Acous1/mmlab-12PhaseDrive-388Slave/SlaveDesignFiles/pinmap_sheet1/28388_0305.xlsx

功能分类 | 管脚序号 | 管脚功能 | 网标 | 复用IO说明 |  | 备注
CAN |  | CANA_TX | DSP_A_CAN_TX | 4 |  | CAN
 |  | CANA_RX | DSP_A_CAN_RX | 5
 |  | CANB_TX | DSP_B_CAN_TX | 8
 |  | CANB_RX | DSP_B_CAN_RX | 10
 |  | GPIO2 | DSP_A_CAN_EN | 2
 |  | GPIO9 | DSP_B_CAN_EN | 9
EQEP |  | EQEP1_A | MQEP1A | 50 |  | EQEP
 |  | EQEP1_B | MQEP1B | 51
 |  | EQEP1_INDEX | MQEP1Z | 53
SPI |  | SPIB_SOMI | MCU_EnDO_B1 | 25 | SPI数据从输出主输入 | 绝对编码器
 |  | SPIB_SIMO | MCU_EnDI_B1 | 24 | SPI数据主输出从输入
 |  | CLB_OUTPUTXBAR2 | MCU_CLK_B1 | 33 | CLK
 |  | GPIO7 | MCU_PwrEn_B1 | 7 | PwrEn
 |  | SPIB_SOMI | MCU_EnDO_B2 | 64 | SPI数据从输出主输入
 |  | SPIB_SIMO | MCU_EnDI_B2 | 63 | SPI数据主输出从输入
 |  | CLB_OUTPUTXBAR5 | MCU_CLK_B2 | 36 | CLK
 |  | GPIO95 | MCU_PwrEn_B2 | 95 | PwrEn
 |  | CLB_OUTPUTXBAR6 | MCU_TxEn_B | 96 | TxEn
 |  | SPID_SOMI | MCU_EnDO_D1 | 31 | SPI数据从输出主输入
 |  | SPID_SIMO | MCU_EnDI_D1 | 30 | SPI数据主输出从输入
 |  | CLB_OUTPUTXBAR1 | MCU_CLK_D1 | 32 | CLK
 |  | GPIO52 | MCU_PwrEn_D1 | 52 | PwrEn
 |  | SPID_SOMI | MCU_EnDO_D2 | 92 | SPI数据从输出主输入
 |  | SPID_SIMO | MCU_EnDI_D2 | 91 | SPI数据主输出从输入
 |  | CLB_OUTPUTXBAR8 | MCU_CLK_D2 | 98 | CLK
 |  | GPIO83 | MCU_PwrEn_D2 | 83 | PwrEn
 |  | CLB_OUTPUTXBAR7 | MCU_TxEn_D | 97 | TxEn
GPIO |  | GPIO43 | HALL_W | 43 |  | 增量式编码器 x_bar
 |  | GPIO42 | HALL_V | 42
 |  | GPIO133 | HALL_U | 133
 |  | GPIO113 | LED1 | 113 |  | LED
 |  | GPIO114 | LED2 | 114
 |  | GPIO118 | LED3 | 118
 |  | GPIO125 | LED4 | 125
 |  | GPIO120 | DI-1-DSP-3.3V | 120 |  | 数字输入
 |  | GPIO121 | DI-2-DSP-3.3V | 121
 |  | GPIO85 | DSP_PWM1~{_ENABL}E | 85 |  | PWM使能
 |  | GPIO88 | DSP_PWM2~{_ENABL}E | 88
 |  | GPIO89 | DSP_PWM3~{_ENABL}E | 89
 |  | GPIO90 | DSP_PWM4~{_ENABL}E | 90
 |  | GPIO93 | DSP_PWM1_~{FAULT} | 93 |  | 警告信号
 |  | GPIO94 | DSP_PWM2_~{FAULT} | 94
 |  | GPIO109 | DSP_PWM3_~{FAULT} | 109
 |  | GPIO117 | DSP_PWM4_~{FAULT} | 117
I2C |  | I2CB_SCL | MSCLB | 69 |  | 位移传感器
 |  | I2CB_SDA | MSDAB | 66
 |  | I2CA_SCL | MSCLA | 1
 |  | I2CA_SDA | MSDAA | 0
ADC | U2 | ADCINA2 | IPM_VDC_BUS1 |  |  | 电压AD
 | T2 | ADCINA3 | IPM_VDC_BUS2
 | V3 | ADCINB2 | IPM_VDC_BUS3
 | W3 | ADCINB3 | IPM_VDC_BUS4
 | V4 | ADCINB4 | IPM_Temperatur1 |  |  | 温度AD
 | W4 | ADCINB5 | IPM_Temperature2
 | R3 | ADCINC2 | IPM_Temperature3
 | P3 | ADCINC3 | IPM_Temperature4
PWM |  | EPWM1A | DSP-PWM1A | 145 |  | PWM波
 |  | EPWM1B | DSP-PWM1B | 146
 |  | EPWM2A | DSP-PWM2A | 147
 |  | EPWM2B | DSP-PWM2B | 3
 |  | EPWM3A | DSP-PWM3A | 149
 |  | EPWM3B | DSP-PWM3B | 150
 |  | EPWM4A | DSP-PWM4A | 151
 |  | EPWM4B | DSP-PWM4B | 152
 |  | EPWM5A | DSP-PWM5A | 153
 |  | EPWM5B | DSP-PWM5B | 154
 |  | EPWM6A | DSP-PWM6A | 155
 |  | EPWM6B | DSP-PWM6B | 11
 |  | EPWM7A | DSP-PWM7A | 12
 |  | EPWM7B | DSP-PWM7B | 13
 |  | EPWM8A | DSP-PWM8A | 14
 |  | EPWM8B | DSP-PWM8B | 15
 |  | EPWM9A | DSP-PWM9A | 16
 |  | EPWM9B | DSP-PWM9B | 17
 |  | EPWM10A | DSP-PWM10A | 18
 |  | EPWM10B | DSP-PWM10B | 19
 |  | EPWM11A | DSP-PWM11A | 20
 |  | EPWM11B | DSP-PWM11B | 21
 |  | EPWM12A | DSP-PWM12A | 22
 |  | EPWM12B | DSP-PWM12B | 23
 |  | EPWM15A | DSP_Discharge1_EN | 28 |  | 刹车发波
 |  | EPWM15B | DSP_Discharge2_EN | 29
 |  | EPWM16A | DSP_Discharge3_EN | 143
 |  | EPWM16B | DSP_Discharge4_EN | 144
ETHERCAT | B13 | ESC_I2C_SDA | ESC_I2C_SDA | 40 |  | ETHERCAT网口*2
 | C13 | ESC_I2C_SCL | ESC_I2C_SCL | 41
 | D13 | ESC_MDIO_CLK | ESC_MDC | 46
 | A12 | ESC_MDIO_DATA | ESC_MDIO | 47
 | B12 | ESC_PHY_CLK | ESC_PHY_CLK | 48
 | C12 | ESC_PHY_RESETn | ESC_RESET | 76
 | D12 | ESC_TX0_ENA | ESC_TX0_EN | 156
 | B10 | ESC_TX0_CLK | ESC_TX0_CLK | 157
 | C10 | ESC_TX0_DATA0 | ESC_TX0_D0 | 158
 | D10 | ESC_TX0_DATA1 | ESC_TX0_D1 | 159
 | B9 | ESC_TX0_DATA2 | ESC_TX0_D2 | 160
 | C9 | ESC_TX0_DATA3 | ESC_TX0_D3 | 161
 | D9 | ESC_RX0_DV | ESC_RX0_DV | 162
 | A8 | ESC_RX0_CLK | ESC_RX0_CLK | 163
 | B8 | ESC_RX0_ERR | ESC_RX0_ERR | 164
 | C5 | ESC_RX0_DATA0 | ESC_RX0_D0 | 165
 | D5 | ESC_RX0_DATA1 | ESC_RX0_D1 | 166
 | C4 | ESC_RX0_DATA2 | ESC_RX0_D2 | 167
 | D4 | ESC_RX0_DATA3 | ESC_RX0_D3 | 168
 | T10 | ESC_TX1_ENA | ESC_TX1_EN | 129
 | U10 | ESC_TX1_CLK | ESC_TX1_CLK | 130
 | V10 | ESC_TX1_DATA0 | ESC_TX1_D0 | 131
 | W18 | ESC_TX1_DATA1 | ESC_TX1_D1 | 132
 | V18 | ESC_TX1_DATA2 | ESC_TX1_D2 | 134
 | U18 | ESC_TX1_DATA3 | ESC_TX1_D3 | 135
 | T17 | ESC_RX1_DV | ESC_RX1_DV | 136
 | T18 | ESC_RX1_CLK | ESC_RX1_CLK | 137
 | T19 | ESC_RX1_ERR | ESC_RX1_ERR | 71
 | N19 | ESC_RX1_DATA0 | ESC_RX1_D0 | 139
 | M19 | ESC_RX1_DATA1 | ESC_RX1_D1 | 140
 | K16 | ESC_RX1_DATA2 | ESC_RX1_D2 | 141
 | L19 | ESC_RX1_DATA3 | ESC_RX1_D3 | 142
 | F18 | ESC_LED_LINK0_ACTIVE | ESC_LED_LINK0 | 58
 | F17 | ESC_LED_LINK1_ACTIVE | ESC_LED_LINK1 | 59
 | E17 | ESC_LED_ERR | ESC_LED_ERR | 60
 | D18 | ESC_LED_RUN | ESC_LED_RUN | 61
 | D14 | ESC_PHY0_LINKSTATUS | ESC_PHY0 | 148
 | A13 | ESC_PHY1_LINKSTATUS | ESC_PHY1 | 68
 | A16 | XCLKOUT | XCLKOUT | 73
SDFM |  | SD1_C1 | ADC_CLK_1 | 49 | SDFM1模拟时钟输入 | AD电流检测
 |  | SD2_C1 | ADC_CLK_3 | 80 | SDFM3模拟时钟输入
 |  | SD1_D1 | ADC_DO_V_1 | 122 | 1-V相电流
 |  | SD1_D2 | ADC_DO_W_1 | 124 | 1-W相电流
 |  | SD1_D3 | ADC_DO_V_2 | 126 | 2-V相电流
 |  | SD1_D4 | ADC_DO_W_2 | 128 | 2-W相电流
 |  | SD2_D1 | ADC_DO_V_3 | 79 | 3-V相电流
 |  | SD2_D2 | ADC_DO_W_3 | 26 | 3-W相电流
 |  | SD2_D3 | ADC_DO_V_4 | 75 | 4-V相电流
 |  | SD2_D4 | ADC_DO_W_4 | 77 | 4-W相电流
FSI |  | FSIRXA_CLK | FSI_RXA_CLK | 105 |  | FSI*2
 |  | FSIRXA_D0 | FSI_RXA_D0 | 103
 |  | FSIRXA_D1 | FSI_RXA_D1 | 104
 |  | FSIRXB_CLK | FSI_RXB_CLK | 112
 |  | FSIRXB_D0 | FSI_RXB_D0 | 110
 |  | FSIRXB_D1 | FSI_RXB_D1 | 111
 |  | FSITXA_CLK | FSI_TXA_CLK | 102
 |  | FSITXA_D0 | FSI_TXA_D0 | 100
 |  | FSITXA_D1 | FSI_TXA_D1 | 101
 |  | FSITXB_CLK | FSI_TXB_CLK | 108
 |  | FSITXB_D0 | FSI_TXB_D0 | 106
 |  | FSITXB_D1 | FSI_TXB_D1 | 107
485上位机 |  | SCIA_TX | USB485_TXD | 34 |  | 485通讯转USB
 |  | SCIA_RX | USB485_RXD | 35
SPI |  | SPIA_SIMO | SPI_A_MO_HS | 54 |  | DAC
 |  | SPIA_SOMI | SPI_A_MI_HS | 55
 |  | SPIA_CLK | SPI_A_CK_HS | 56
 |  | SPIA_STEn | ~{SPI_A_STE_HS} | 57
高速485 |  | SCIB_TX | MCU_485D_1 | 86 |  | 485
 |  | SCIB_RX | MCU_485R_1 | 87
 |  | GPIO138 | 485_RTS_1 | 138
 |  | SCIC_TX | MCU_485D_2 | 38
 |  | SCIC_RX | MCU_485R_2 | 39
 |  | GPIO45 | 485_RTS_2 | 45
 |  |  |  | 72 |  | BOOT
 |  |  |  | 84
