Acous1/mmlab-12PhaseDrive-388Slave/SlaveDesignFiles/嘉立创叠层选择.png

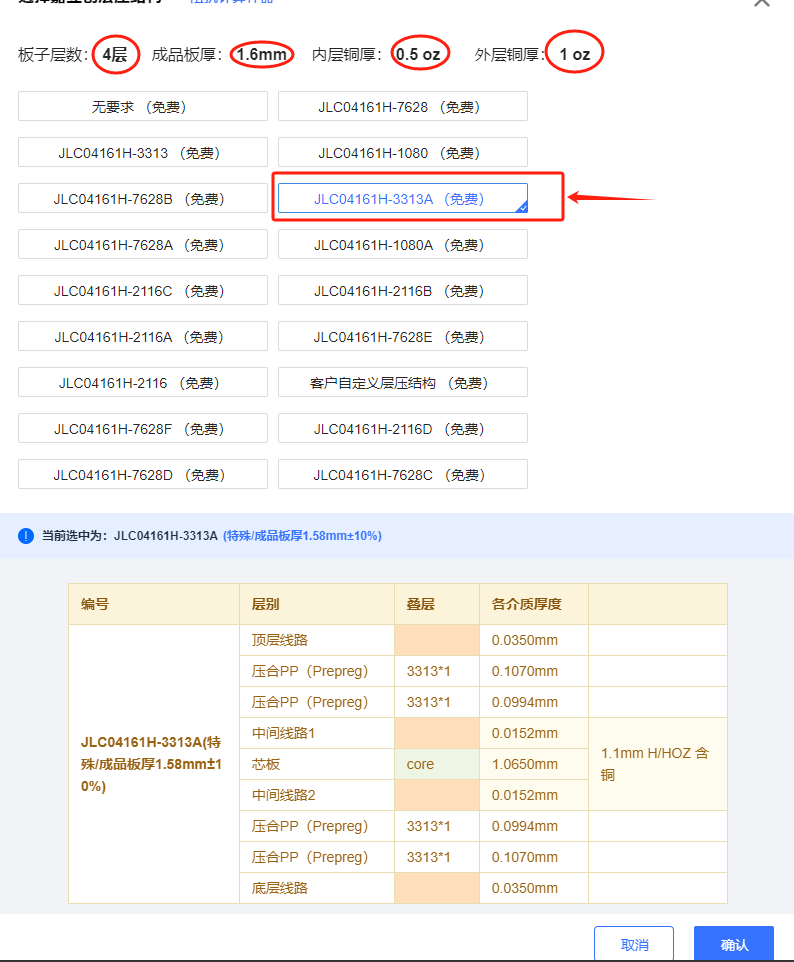
SlaveDesignFiles/嘉立创叠层选择.png
