Acous1/mmlab-12PhaseDrive-388Slave/SlaveDesignFiles/阻抗叠层下的线宽线距计算.png

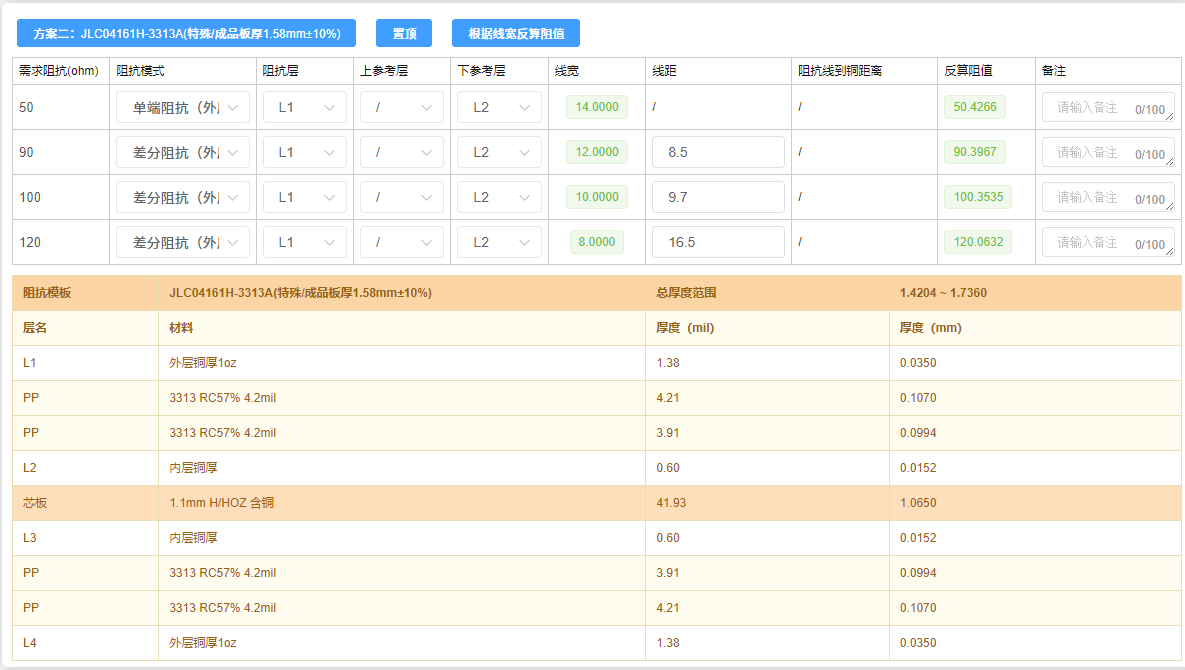
SlaveDesignFiles/阻抗叠层下的线宽线距计算.png
