Acous1/mmlab-12PhaseDrive-388Slave/SlaveDesignFiles/2.kicad_sch

## KiCad design SlaveDesignFiles/2.kicad_sch (2025-04-16)

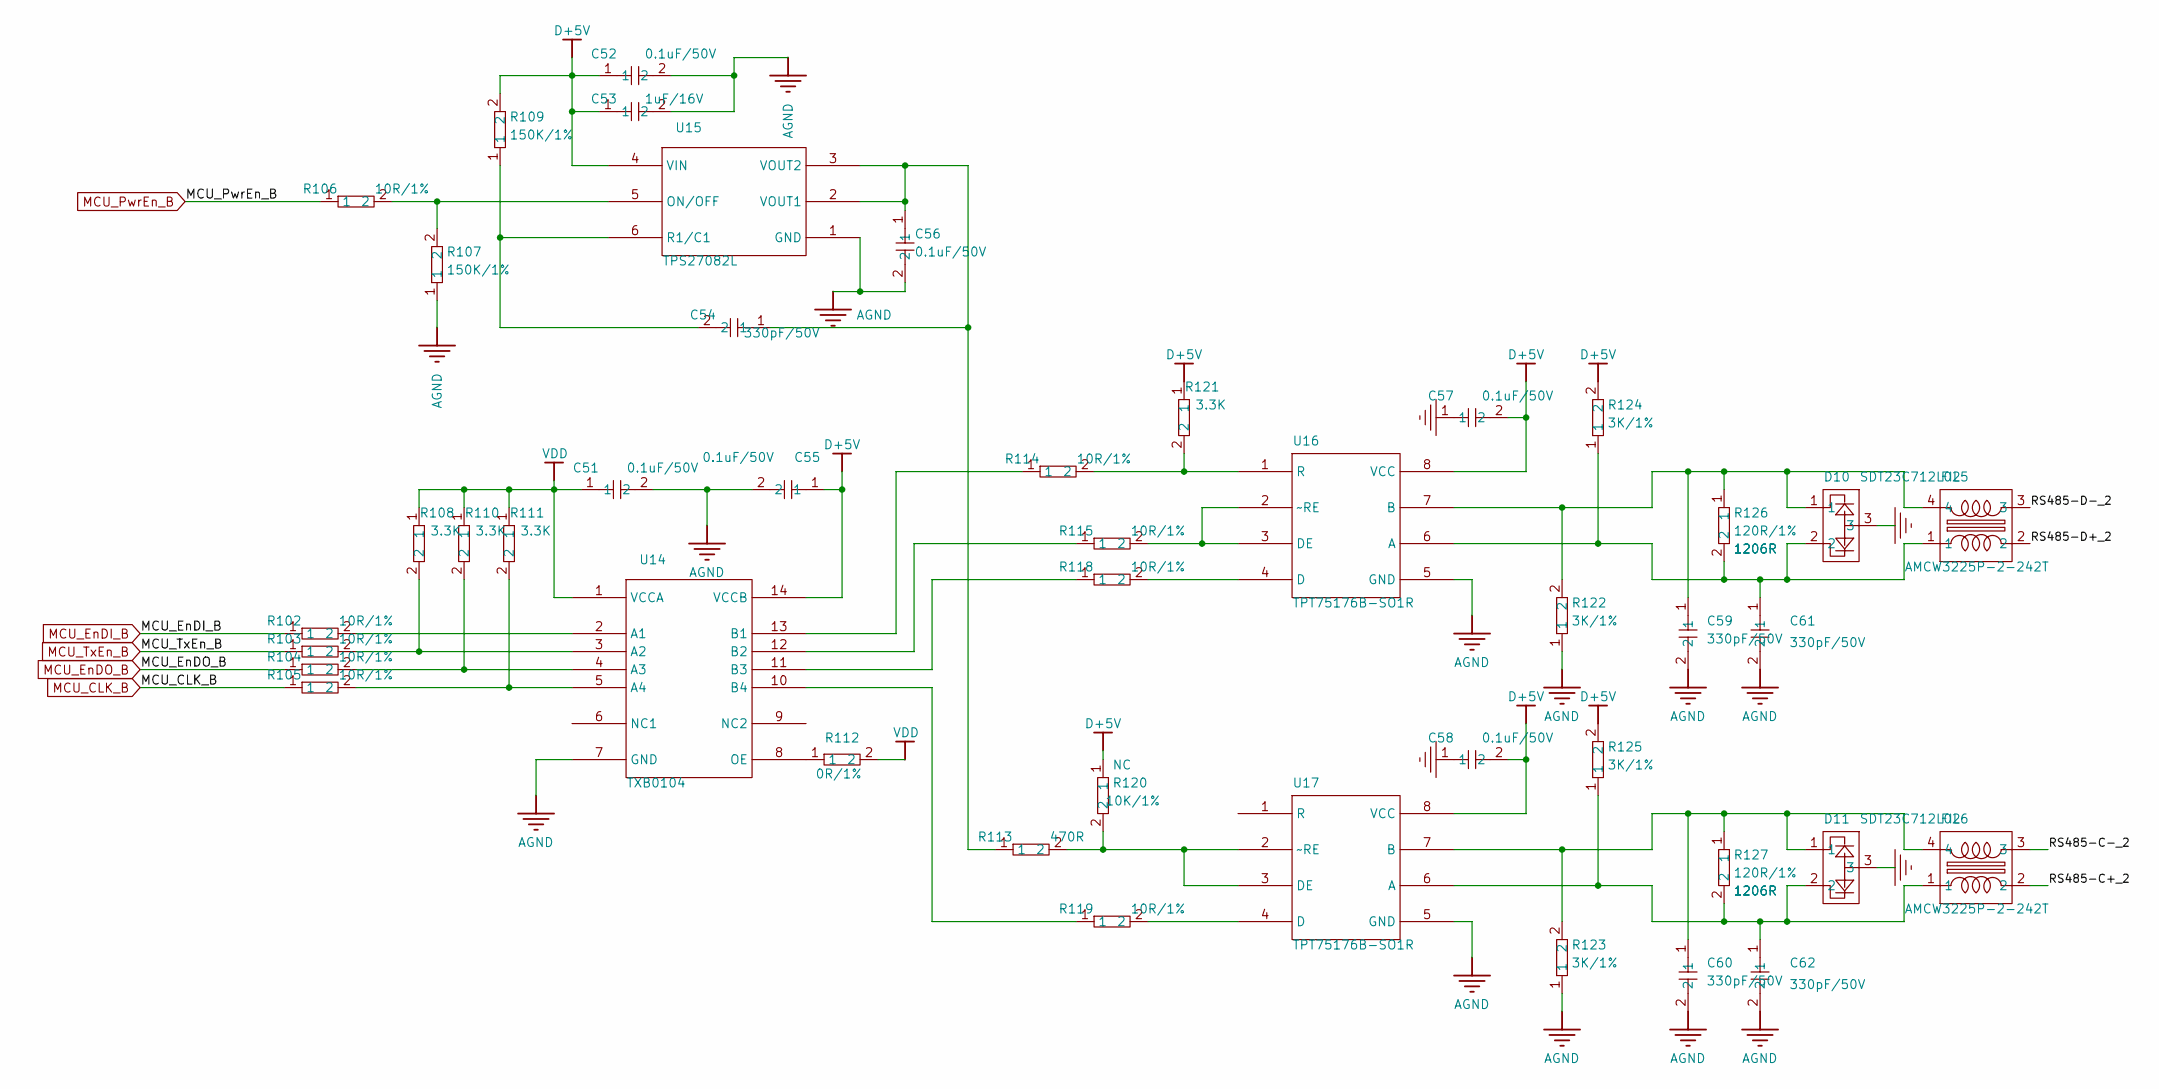
[picture p5: schematic 2.kicad_sch]

Parts:
C51, C52, C55, C56, C57, C58: 0.1uF/50V; Part State 已认定
C53: 1uF/16V; Part State 已认定
C54, C59, C60, C61, C62: 330pF/50V; Part State 已认定
D10, D11: SDT23C712L02
FIL5, FIL6: AMCW3225P-2-242T
R102, R103, R104, R105, R106, R114, R115, R118, R119: 10R/1%; Part State 已认定
R107, R109: 150K/1%; Part State 已认定
R108, R110, R111, R121: 3.3K; Part State 已认定
R112: 0R/1%; Part State 已认定
R113: 470R; Part State 已认定
R120: 10K/1%; Part State 已认定
R122, R123, R124, R125: 3K/1%; Part State 未认定
R126, R127: 120R/1%; Part State 已认定
U14: TXB0104
U15: TPS27082L
U16, U17: TPT75176B-SO1R

Connections:
AGND: C51.2, C52.2, C53.2, C55.2, C56.2, C59.2, C60.2, C61.2, C62.2, R107.1, R122.1, R123.1, U14.7 (GND), U15.1 (GND), U16.5 (GND), U17.5 (GND)
D+5V: C52.1, C53.1, C55.1, C57.2, C58.2, R109.2, R120.1, R121.1, R124.2, R125.2, U14.14 (VCCB), U15.4 (VIN), U16.8 (VCC), U17.8 (VCC)
GND: C57.1, C58.1, D10.3, D11.3
MCU_CLK_B: R105.1
MCU_EnDI_B: R102.1
MCU_EnDO_B: R104.1
MCU_PwrEn_B: R106.1
MCU_TxEn_B: R103.1
unnamed: C54.1, C56.1, R113.1, U15.2 (VOUT1), U15.3 (VOUT2)
unnamed: C54.2, R109.1, U15.6 (R1/C1)
unnamed: C59.1, D10.1, FIL5.4, R122.2, R126.1, U16.7 (B)
unnamed: C60.1, D11.1, FIL6.4, R123.2, R127.1, U17.7 (B)
unnamed: C61.1, D10.2, FIL5.1, R124.1, R126.2, U16.6 (A)
unnamed: C62.1, D11.2, FIL6.1, R125.1, R127.2, U17.6 (A)
unnamed: R102.2, U14.2 (A1)
unnamed: R103.2, R108.2, U14.3 (A2)
unnamed: R104.2, R110.2, U14.4 (A3)
unnamed: R105.2, R111.2, U14.5 (A4)
unnamed: R106.2, R107.2, U15.5 (ON/OFF)
unnamed: R112.1, U14.8 (OE)
unnamed: R113.2, R120.2, U17.2 (~RE), U17.3 (DE)
unnamed: R114.1, U14.13 (B1)
unnamed: R114.2, R121.2, U16.1 (R)
unnamed: R115.1, U14.12 (B2)
unnamed: R115.2, U16.2 (~RE), U16.3 (DE)
unnamed: R118.1, U14.11 (B3)
unnamed: R118.2, U16.4 (D)
unnamed: R119.1, U14.10 (B4)
unnamed: R119.2, U17.4 (D)
RS485-C+_2: FIL6.2
RS485-C-_2: FIL6.3
RS485-D+_2: FIL5.2
RS485-D-_2: FIL5.3
VDD: C51.1, R108.1, R110.1, R111.1, R112.2, U14.1 (VCCA)
