Acous1/mmlab-12PhaseDrive-388Slave/SlaveDesignFiles/3.kicad_sch

## KiCad design SlaveDesignFiles/3.kicad_sch (2025-04-16)

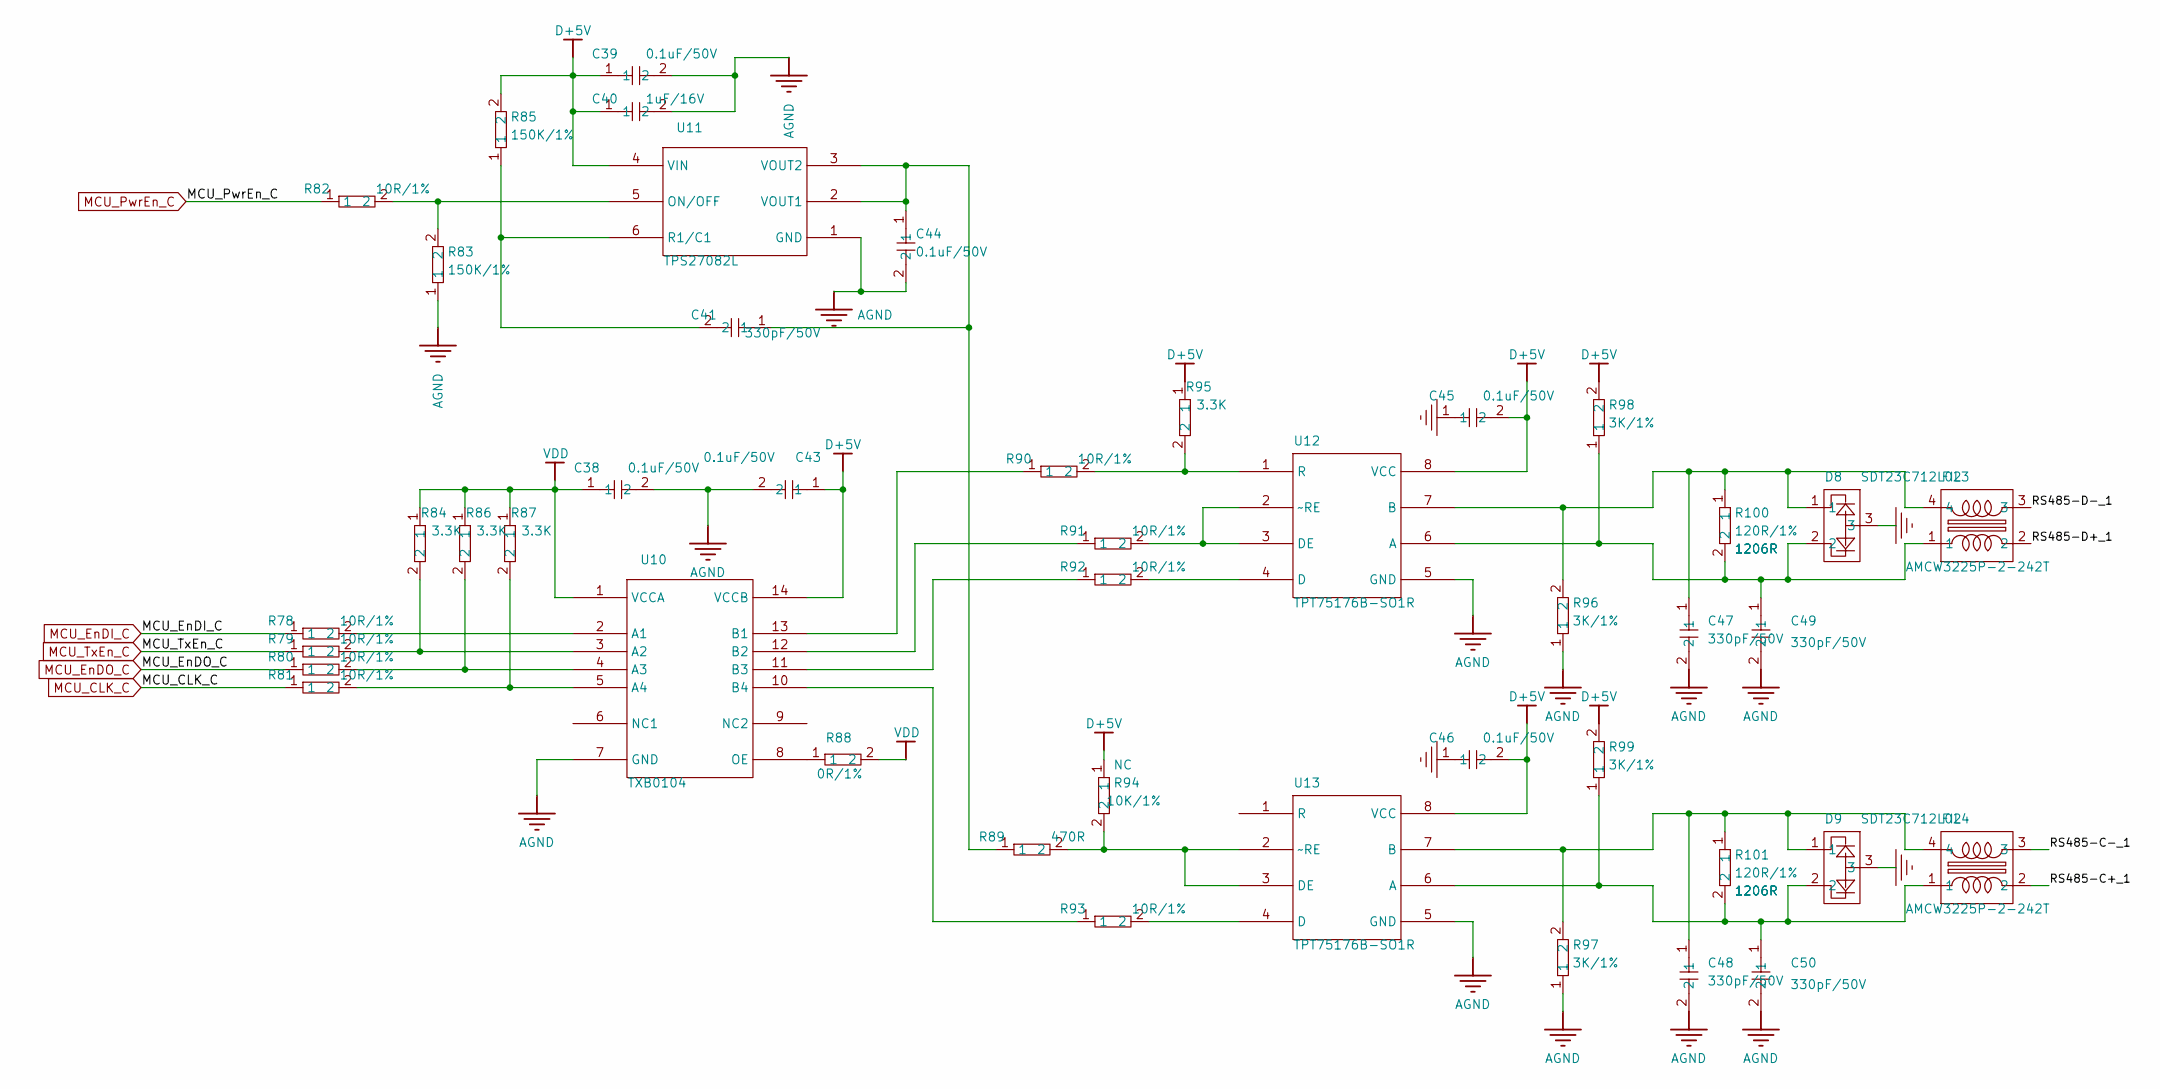
[picture p6: schematic 3.kicad_sch]

Parts:
C38, C39, C43, C44, C45, C46: 0.1uF/50V; Part State 已认定
C40: 1uF/16V; Part State 已认定
C41, C47, C48, C49, C50: 330pF/50V; Part State 已认定
D8, D9: SDT23C712L02
FIL3, FIL4: AMCW3225P-2-242T
R78, R79, R80, R81, R82, R90, R91, R92, R93: 10R/1%; Part State 已认定
R83, R85: 150K/1%; Part State 已认定
R84, R86, R87, R95: 3.3K; Part State 已认定
R88: 0R/1%; Part State 已认定
R89: 470R; Part State 已认定
R94: 10K/1%; Part State 已认定
R96, R97, R98, R99: 3K/1%; Part State 未认定
R100, R101: 120R/1%; Part State 已认定
U10: TXB0104
U11: TPS27082L
U12, U13: TPT75176B-SO1R

Connections:
AGND: C38.2, C39.2, C40.2, C43.2, C44.2, C47.2, C48.2, C49.2, C50.2, R83.1, R96.1, R97.1, U10.7 (GND), U11.1 (GND), U12.5 (GND), U13.5 (GND)
D+5V: C39.1, C40.1, C43.1, C45.2, C46.2, R85.2, R94.1, R95.1, R98.2, R99.2, U10.14 (VCCB), U11.4 (VIN), U12.8 (VCC), U13.8 (VCC)
GND: C45.1, C46.1, D8.3, D9.3
MCU_CLK_C: R81.1
MCU_EnDI_C: R78.1
MCU_EnDO_C: R80.1
MCU_PwrEn_C: R82.1
MCU_TxEn_C: R79.1
unnamed: C41.1, C44.1, R89.1, U11.2 (VOUT1), U11.3 (VOUT2)
unnamed: C41.2, R85.1, U11.6 (R1/C1)
unnamed: C47.1, D8.1, FIL3.4, R96.2, R100.1, U12.7 (B)
unnamed: C48.1, D9.1, FIL4.4, R97.2, R101.1, U13.7 (B)
unnamed: C49.1, D8.2, FIL3.1, R98.1, R100.2, U12.6 (A)
unnamed: C50.1, D9.2, FIL4.1, R99.1, R101.2, U13.6 (A)
unnamed: R78.2, U10.2 (A1)
unnamed: R79.2, R84.2, U10.3 (A2)
unnamed: R80.2, R86.2, U10.4 (A3)
unnamed: R81.2, R87.2, U10.5 (A4)
unnamed: R82.2, R83.2, U11.5 (ON/OFF)
unnamed: R88.1, U10.8 (OE)
unnamed: R89.2, R94.2, U13.2 (~RE), U13.3 (DE)
unnamed: R90.1, U10.13 (B1)
unnamed: R90.2, R95.2, U12.1 (R)
unnamed: R91.1, U10.12 (B2)
unnamed: R91.2, U12.2 (~RE), U12.3 (DE)
unnamed: R92.1, U10.11 (B3)
unnamed: R92.2, U12.4 (D)
unnamed: R93.1, U10.10 (B4)
unnamed: R93.2, U13.4 (D)
RS485-C+_1: FIL4.2
RS485-C-_1: FIL4.3
RS485-D+_1: FIL3.2
RS485-D-_1: FIL3.3
VDD: C38.1, R84.1, R86.1, R87.1, R88.2, U10.1 (VCCA)
