Acous1/mmlab-12PhaseDrive-388Slave/SlaveDesignFiles/4.kicad_sch

## KiCad design SlaveDesignFiles/4.kicad_sch (2025-04-16)

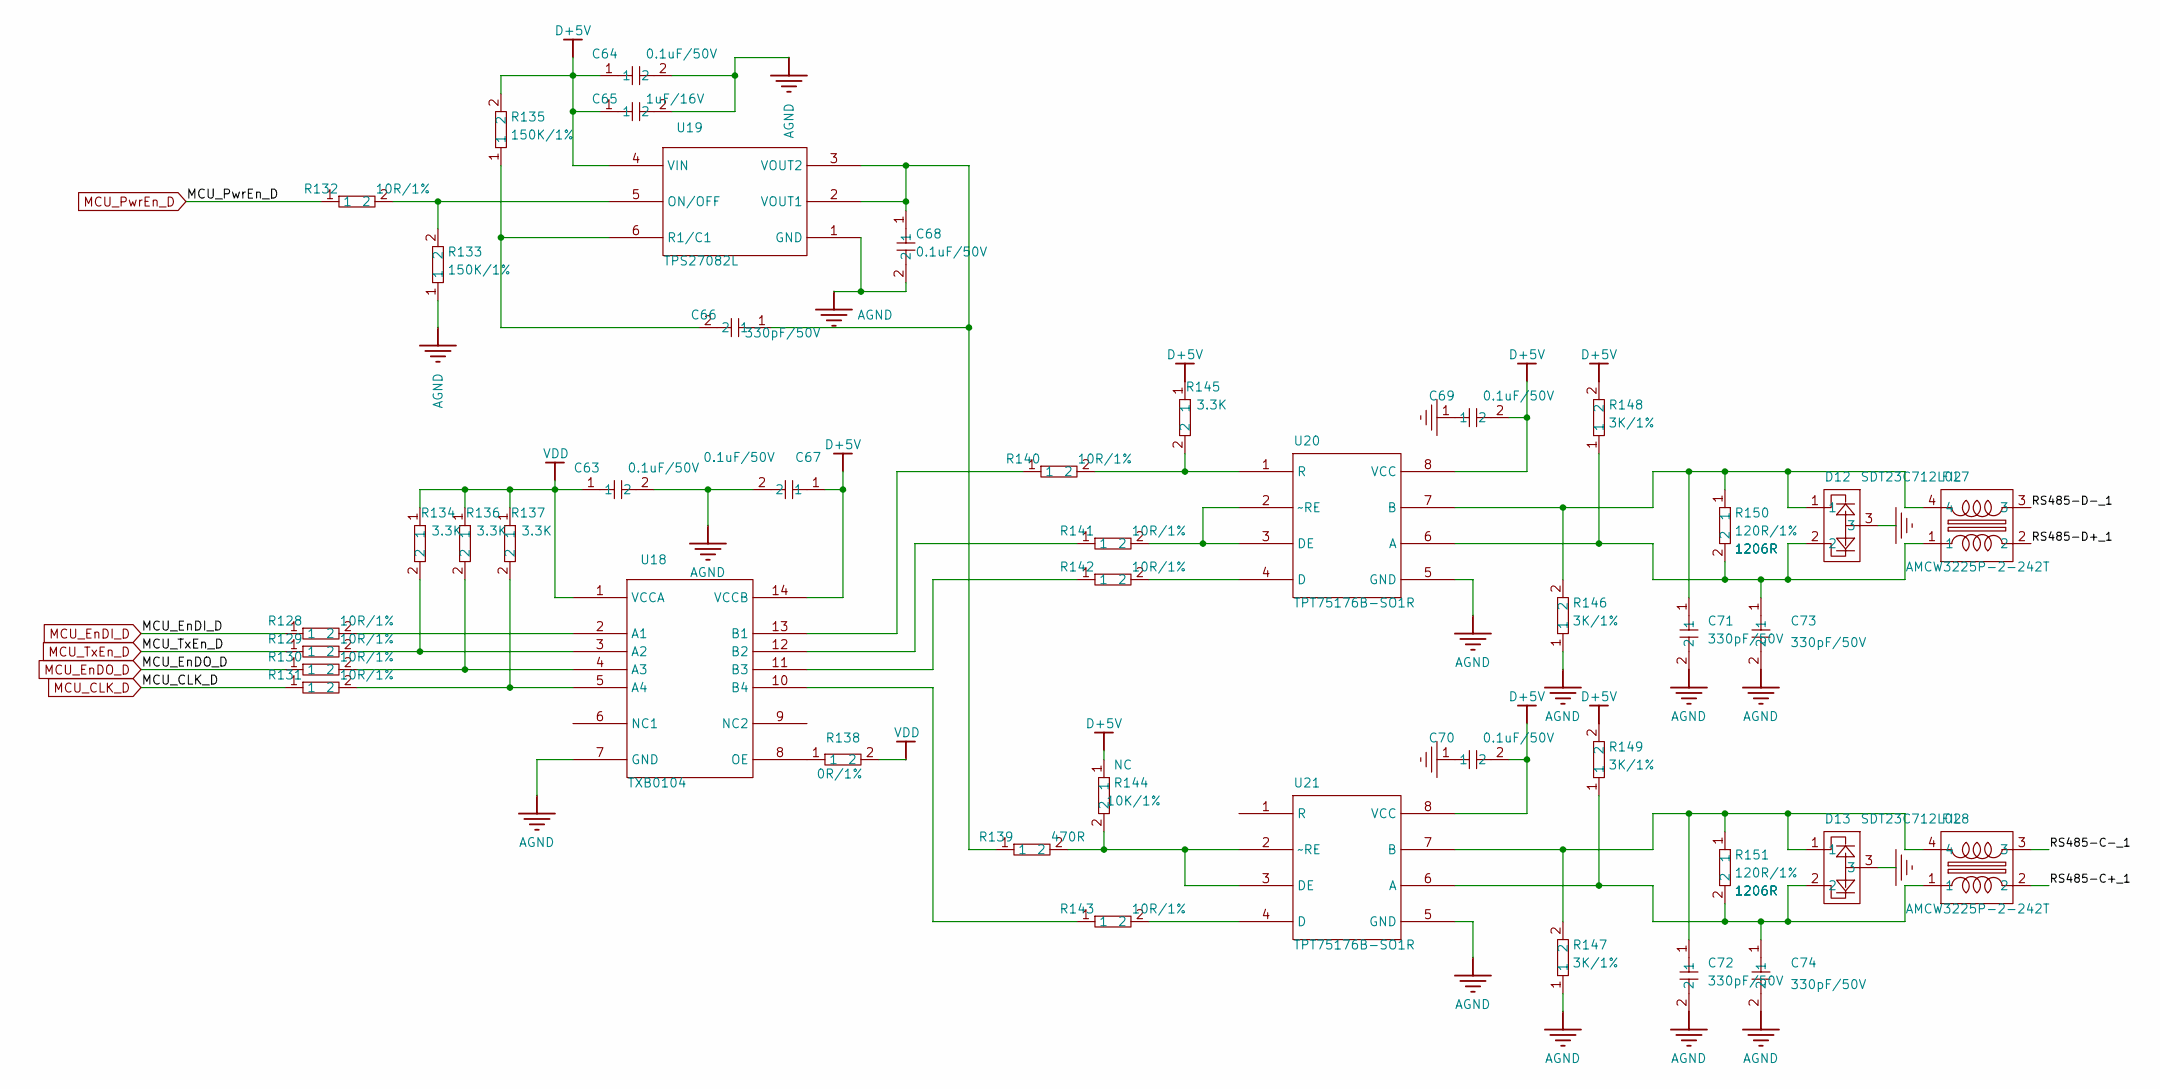
[picture p7: schematic 4.kicad_sch]

Parts:
C63, C64, C67, C68, C69, C70: 0.1uF/50V; Part State 已认定
C65: 1uF/16V; Part State 已认定
C66, C71, C72, C73, C74: 330pF/50V; Part State 已认定
D12, D13: SDT23C712L02
FIL7, FIL8: AMCW3225P-2-242T
R128, R129, R130, R131, R132, R140, R141, R142, R143: 10R/1%; Part State 已认定
R133, R135: 150K/1%; Part State 已认定
R134, R136, R137, R145: 3.3K; Part State 已认定
R138: 0R/1%; Part State 已认定
R139: 470R; Part State 已认定
R144: 10K/1%; Part State 已认定
R146, R147, R148, R149: 3K/1%; Part State 未认定
R150, R151: 120R/1%; Part State 已认定
U18: TXB0104
U19: TPS27082L
U20, U21: TPT75176B-SO1R

Connections:
AGND: C63.2, C64.2, C65.2, C67.2, C68.2, C71.2, C72.2, C73.2, C74.2, R133.1, R146.1, R147.1, U18.7 (GND), U19.1 (GND), U20.5 (GND), U21.5 (GND)
D+5V: C64.1, C65.1, C67.1, C69.2, C70.2, R135.2, R144.1, R145.1, R148.2, R149.2, U18.14 (VCCB), U19.4 (VIN), U20.8 (VCC), U21.8 (VCC)
GND: C69.1, C70.1, D12.3, D13.3
MCU_CLK_D: R131.1
MCU_EnDI_D: R128.1
MCU_EnDO_D: R130.1
MCU_PwrEn_D: R132.1
MCU_TxEn_D: R129.1
unnamed: C66.1, C68.1, R139.1, U19.2 (VOUT1), U19.3 (VOUT2)
unnamed: C66.2, R135.1, U19.6 (R1/C1)
unnamed: C71.1, D12.1, FIL7.4, R146.2, R150.1, U20.7 (B)
unnamed: C72.1, D13.1, FIL8.4, R147.2, R151.1, U21.7 (B)
unnamed: C73.1, D12.2, FIL7.1, R148.1, R150.2, U20.6 (A)
unnamed: C74.1, D13.2, FIL8.1, R149.1, R151.2, U21.6 (A)
unnamed: R128.2, U18.2 (A1)
unnamed: R129.2, R134.2, U18.3 (A2)
unnamed: R130.2, R136.2, U18.4 (A3)
unnamed: R131.2, R137.2, U18.5 (A4)
unnamed: R132.2, R133.2, U19.5 (ON/OFF)
unnamed: R138.1, U18.8 (OE)
unnamed: R139.2, R144.2, U21.2 (~RE), U21.3 (DE)
unnamed: R140.1, U18.13 (B1)
unnamed: R140.2, R145.2, U20.1 (R)
unnamed: R141.1, U18.12 (B2)
unnamed: R141.2, U20.2 (~RE), U20.3 (DE)
unnamed: R142.1, U18.11 (B3)
unnamed: R142.2, U20.4 (D)
unnamed: R143.1, U18.10 (B4)
unnamed: R143.2, U21.4 (D)
RS485-C+_1: FIL8.2
RS485-C-_1: FIL8.3
RS485-D+_1: FIL7.2
RS485-D-_1: FIL7.3
VDD: C63.1, R134.1, R136.1, R137.1, R138.2, U18.1 (VCCA)
