Acous1/mmlab-12PhaseDrive-388Slave/SlaveDesignFiles/5.kicad_sch

## KiCad design SlaveDesignFiles/5.kicad_sch (2025-04-16)

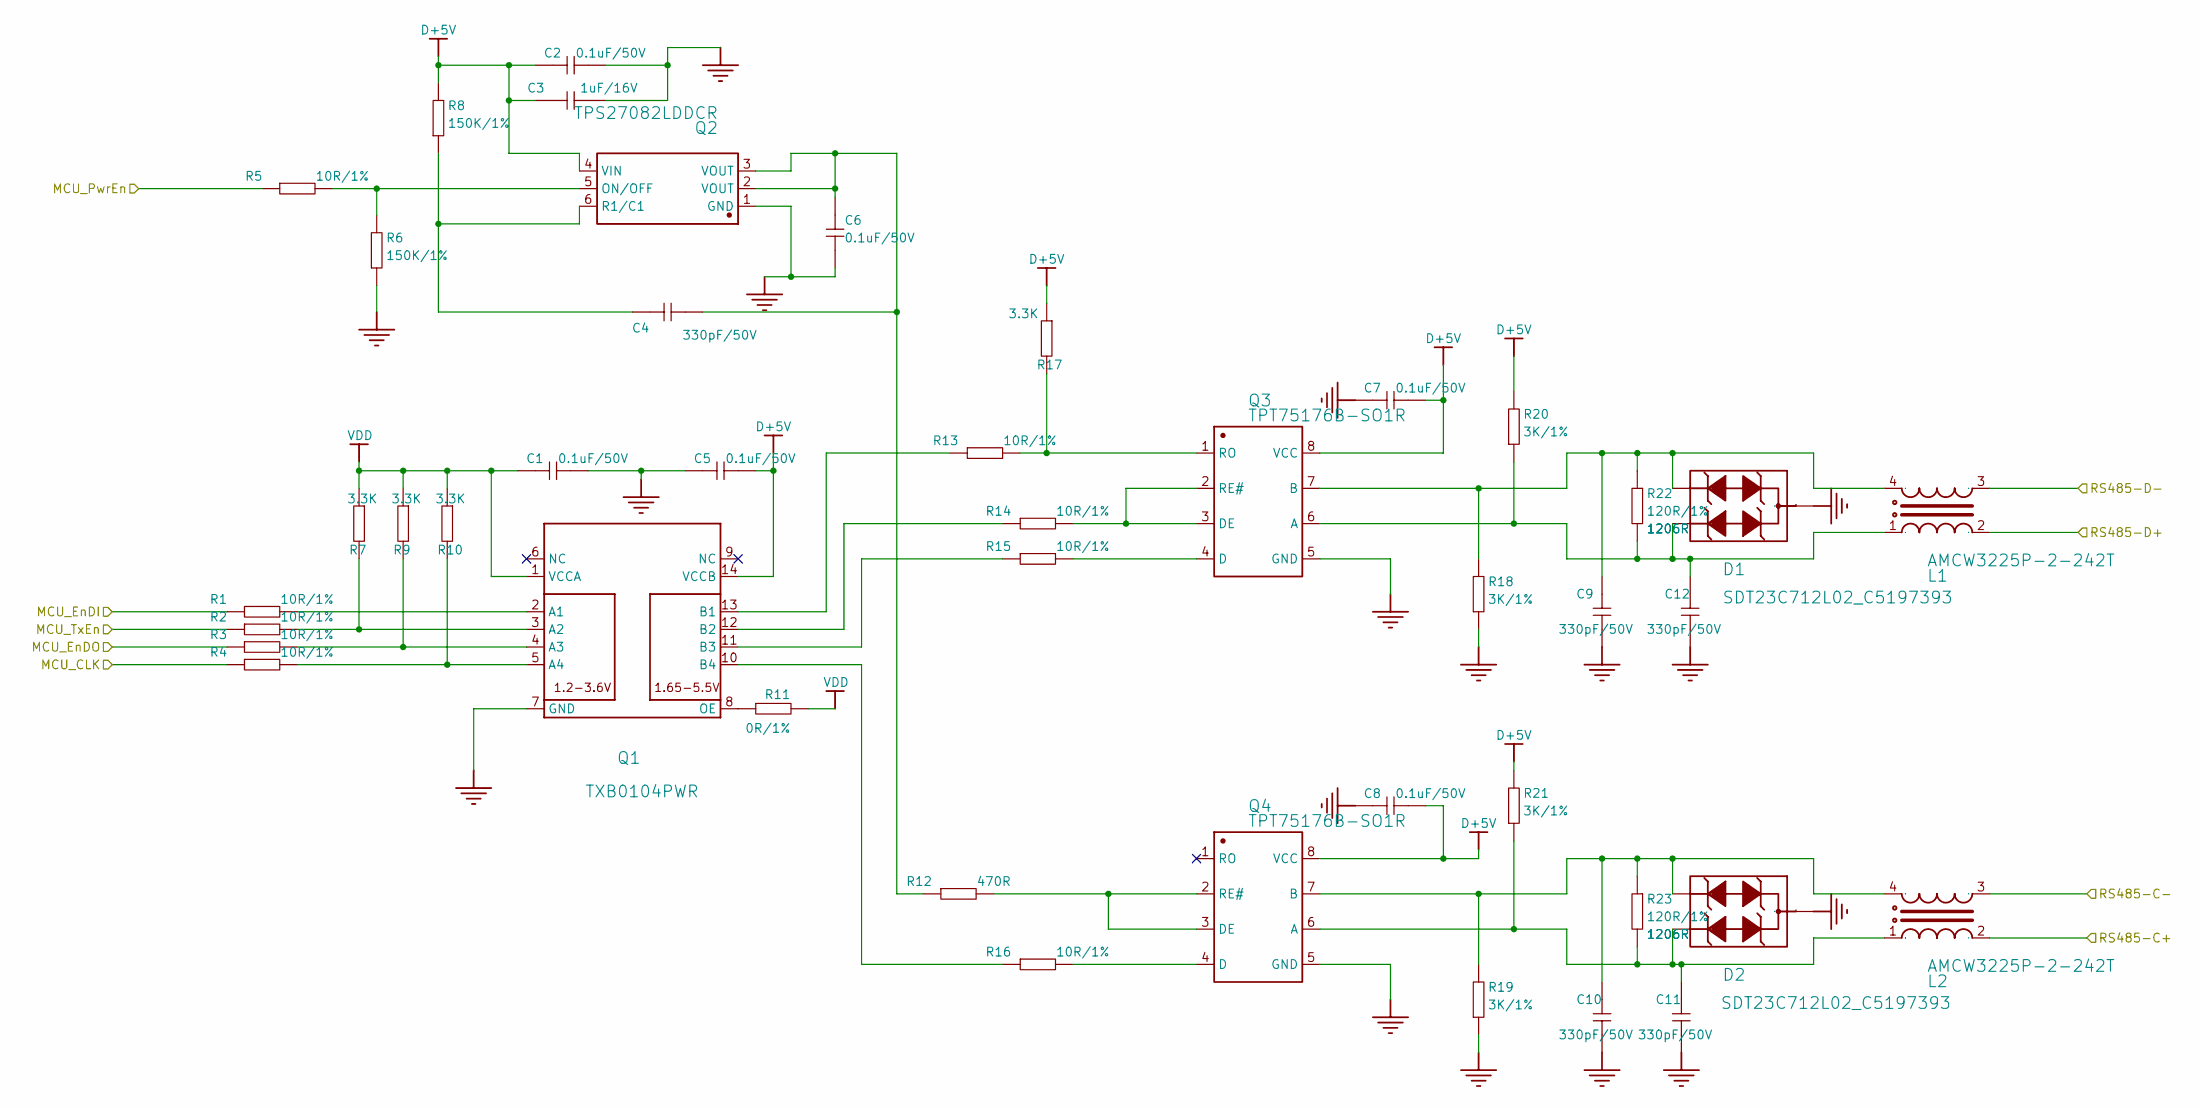
[picture p8: schematic 5.kicad_sch]

Parts:
C1, C2, C5, C6, C7, C8: 0.1uF/50V; C_0603_1608Metric; Part State 已认定
C3: 1uF/16V; C_0603_1608Metric; Part State 已认定
C4, C9, C10, C11, C12: 330pF/50V; C_0603_1608Metric; Part State 已认定
D1, D2: SDT23C712L02_C5197393; SOT-23-3_L2.9-W1.3-P1.90-LS2.4-BR; Manufacturer Part SDT23C712L02
L1, L2: AMCW3225P-2-242T; FILTER-SMD_4P-L3.2-W2.5-BL_WCM3225XXXX; Manufacturer Part AMCW3225P-2-242T
Q1: TXB0104PWR; TSSOP-14_L5.0-W4.4-P0.65-LS6.4-BL; Manufacturer Part TXB0104PWR
Q2: TPS27082LDDCR; SOT-23-6_L2.9-W1.6-P0.95-LS2.8-BR; Manufacturer Part TPS27082LDDCR
Q3, Q4: TPT75176B-SO1R; SOP-8_L4.9-W3.9-P1.27-LS6.0-BL; Manufacturer Part TPT75176B-SO1R
R1, R2, R3, R4, R5, R13, R14, R15, R16: 10R/1%; R_0603_1608Metric; Part State 已认定
R6, R8: 150K/1%; R_0603_1608Metric; Part State 已认定
R7, R9, R10, R17: 3.3K; R_0603_1608Metric; Part State 已认定
R11: 0R/1%; R_0603_1608Metric; Part State 已认定
R12: 470R; R_0603_1608Metric; Part State 已认定
R18, R19, R20, R21: 3K/1%; R_0603_1608Metric; Part State 未认定
R22, R23: 120R/1%; R_1206_3216Metric; Part State 已认定

Connections:
AGND: C1.2, C2.2, C3.2, C5.1, C6.2, C7.1, C8.1, C9.2, C10.2, C11.2, C12.2, D1.3, D2.3, Q1.7 (GND), Q2.1 (GND), Q3.5 (GND), Q4.5 (GND), R6.1, R18.1, R19.1
D+5V: C2.1, C3.1, C5.2, C7.2, C8.2, Q1.14 (VCCB), Q2.4 (VIN), Q3.8 (VCC), Q4.8 (VCC), R8.2, R17.1, R20.2, R21.2
MCU_CLK: R4.1
MCU_EnDI: R1.1
MCU_EnDO: R3.1
MCU_PwrEn: R5.1
MCU_TxEn: R2.1
unnamed: C4.1, Q2.6 (R1/C1), R8.1
unnamed: C4.2, C6.1, Q2.2 (VOUT), Q2.3 (VOUT), R12.1
unnamed: C9.1, D1.1, L1.4, Q3.7 (B), R18.2, R22.1
unnamed: C10.1, D2.1, L2.4, Q4.7 (B), R19.2, R23.1
unnamed: C11.1, D2.2, L2.1, Q4.6 (A), R21.1, R23.2
unnamed: C12.1, D1.2, L1.1, Q3.6 (A), R20.1, R22.2
unnamed: Q1.2 (A1), R1.2
unnamed: Q1.3 (A2), R2.2, R7.2
unnamed: Q1.4 (A3), R3.2, R9.2
unnamed: Q1.5 (A4), R4.2, R10.2
unnamed: Q1.8 (OE), R11.1
unnamed: Q1.10 (B4), R16.1
unnamed: Q1.11 (B3), R15.1
unnamed: Q1.12 (B2), R14.1
unnamed: Q1.13 (B1), R13.1
unnamed: Q2.5 (ON/OFF), R5.2, R6.2
unnamed: Q3.1 (RO), R13.2, R17.2
unnamed: Q3.2 (RE#), Q3.3 (DE), R14.2
unnamed: Q3.4 (D), R15.2
unnamed: Q4.2 (RE#), Q4.3 (DE), R12.2
unnamed: Q4.4 (D), R16.2
RS485-C+: L2.2
RS485-C-: L2.3
RS485-D+: L1.2
RS485-D-: L1.3
VDD: C1.1, Q1.1 (VCCA), R7.1, R9.1, R10.1, R11.2
