Acous1/mmlab-12PhaseDrive-388Slave/SlaveDesignFiles/26c32.kicad_sch

## KiCad design SlaveDesignFiles/26c32.kicad_sch (2025-04-16)

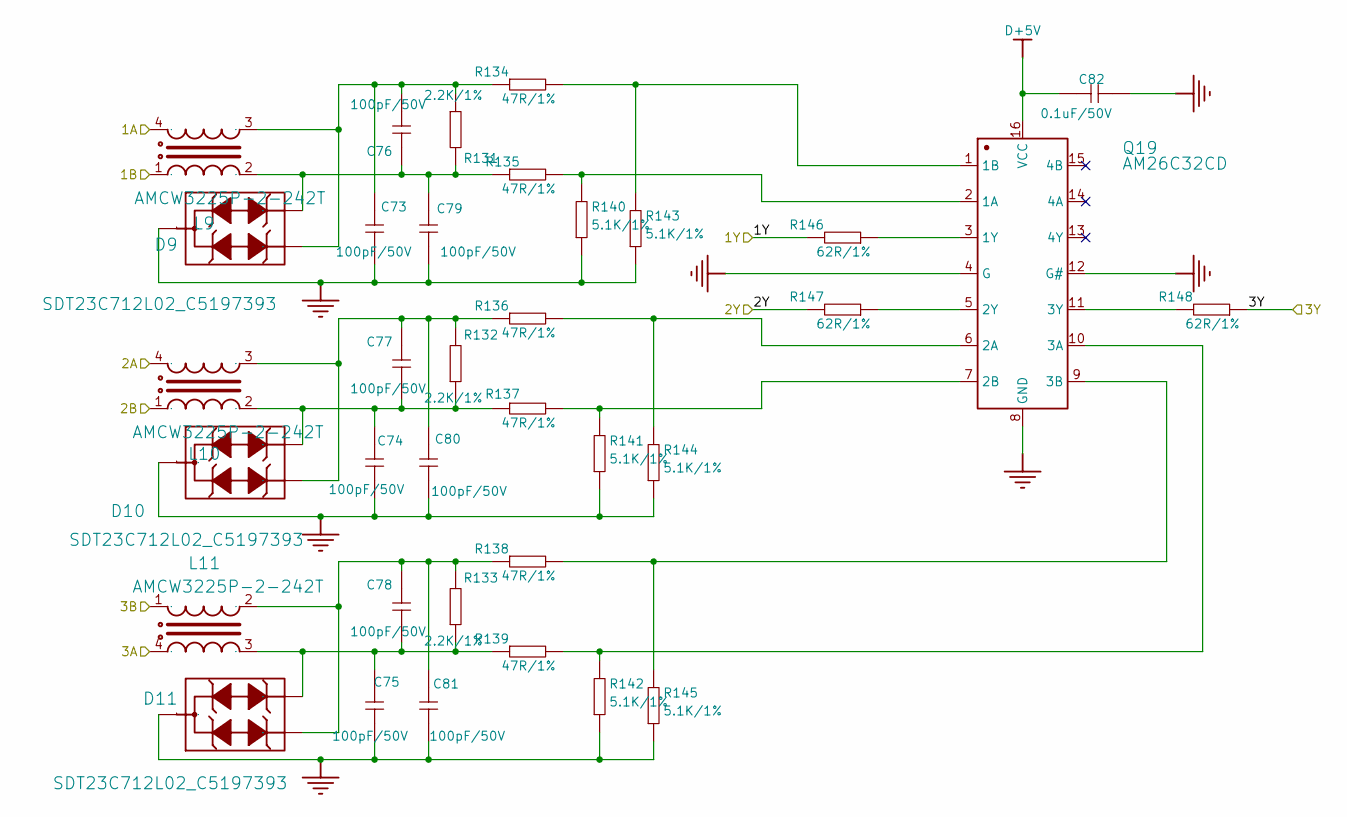
[picture p9: schematic 26c32.kicad_sch]

Parts:
C73, C74, C75, C76, C77, C78, C79, C80, C81: 100pF/50V; C_0603_1608Metric; Part State 已认定
C82: 0.1uF/50V; C_0603_1608Metric; Part State 已认定
D9, D10, D11: SDT23C712L02_C5197393; SOT-23-3_L2.9-W1.3-P1.90-LS2.4-BR; Manufacturer Part SDT23C712L02
L9, L10, L11: AMCW3225P-2-242T; FILTER-SMD_4P-L3.2-W2.5-BL_WCM3225XXXX; Manufacturer Part AMCW3225P-2-242T
Q19: AM26C32CD; SOP-16_L9.9-W3.9-P1.27-LS6.0-BL; Manufacturer Part AM26C32CD
R131, R132, R133: 2.2K/1%; R_0603_1608Metric; Part State 已认定
R134, R135, R136, R137, R138, R139: 47R/1%; R_0603_1608Metric; Part State 已认定
R140, R141, R142, R143, R144, R145: 5.1K/1%; R_0603_1608Metric; Part State 未认定
R146, R147, R148: 62R/1%; R_0603_1608Metric; Part State 已认定

Connections:
1A: L9.4
1B: L9.1
1Y: R146.2
2A: L10.4
2B: L10.1
2Y: R147.2
3A: L11.4
3B: L11.1
3Y: R148.1
AGND: C73.2, C74.2, C75.2, C79.2, C80.2, C81.2, C82.2, D9.3, D10.3, D11.3, Q19.4 (G), Q19.8 (GND), Q19.12 (G#), R140.1, R141.1, R142.1, R143.1, R144.1, R145.1
D+5V: C82.1, Q19.16 (VCC)
unnamed: C73.1, C76.2, D9.2, L9.3, R131.1, R134.1
unnamed: C74.1, C77.2, D10.1, L10.2, R132.1, R137.1
unnamed: C75.1, C78.2, D11.2, L11.3, R133.1, R139.1
unnamed: C76.1, C79.1, D9.1, L9.2, R131.2, R135.1
unnamed: C77.1, C80.1, D10.2, L10.3, R132.2, R136.1
unnamed: C78.1, C81.1, D11.1, L11.2, R133.2, R138.1
unnamed: Q19.1 (1B), R134.2, R143.2
unnamed: Q19.2 (1A), R135.2, R140.2
unnamed: Q19.3 (1Y), R146.1
unnamed: Q19.5 (2Y), R147.1
unnamed: Q19.6 (2A), R136.2, R144.2
unnamed: Q19.7 (2B), R137.2, R141.2
unnamed: Q19.9 (3B), R138.2, R145.2
unnamed: Q19.10 (3A), R139.2, R142.2
unnamed: Q19.11 (3Y), R148.2
