Acous1/mmlab-12PhaseDrive-388Slave/SlaveDesignFiles/ETHERCAT2.kicad_sch

## KiCad design SlaveDesignFiles/ETHERCAT2.kicad_sch (2025-04-16)

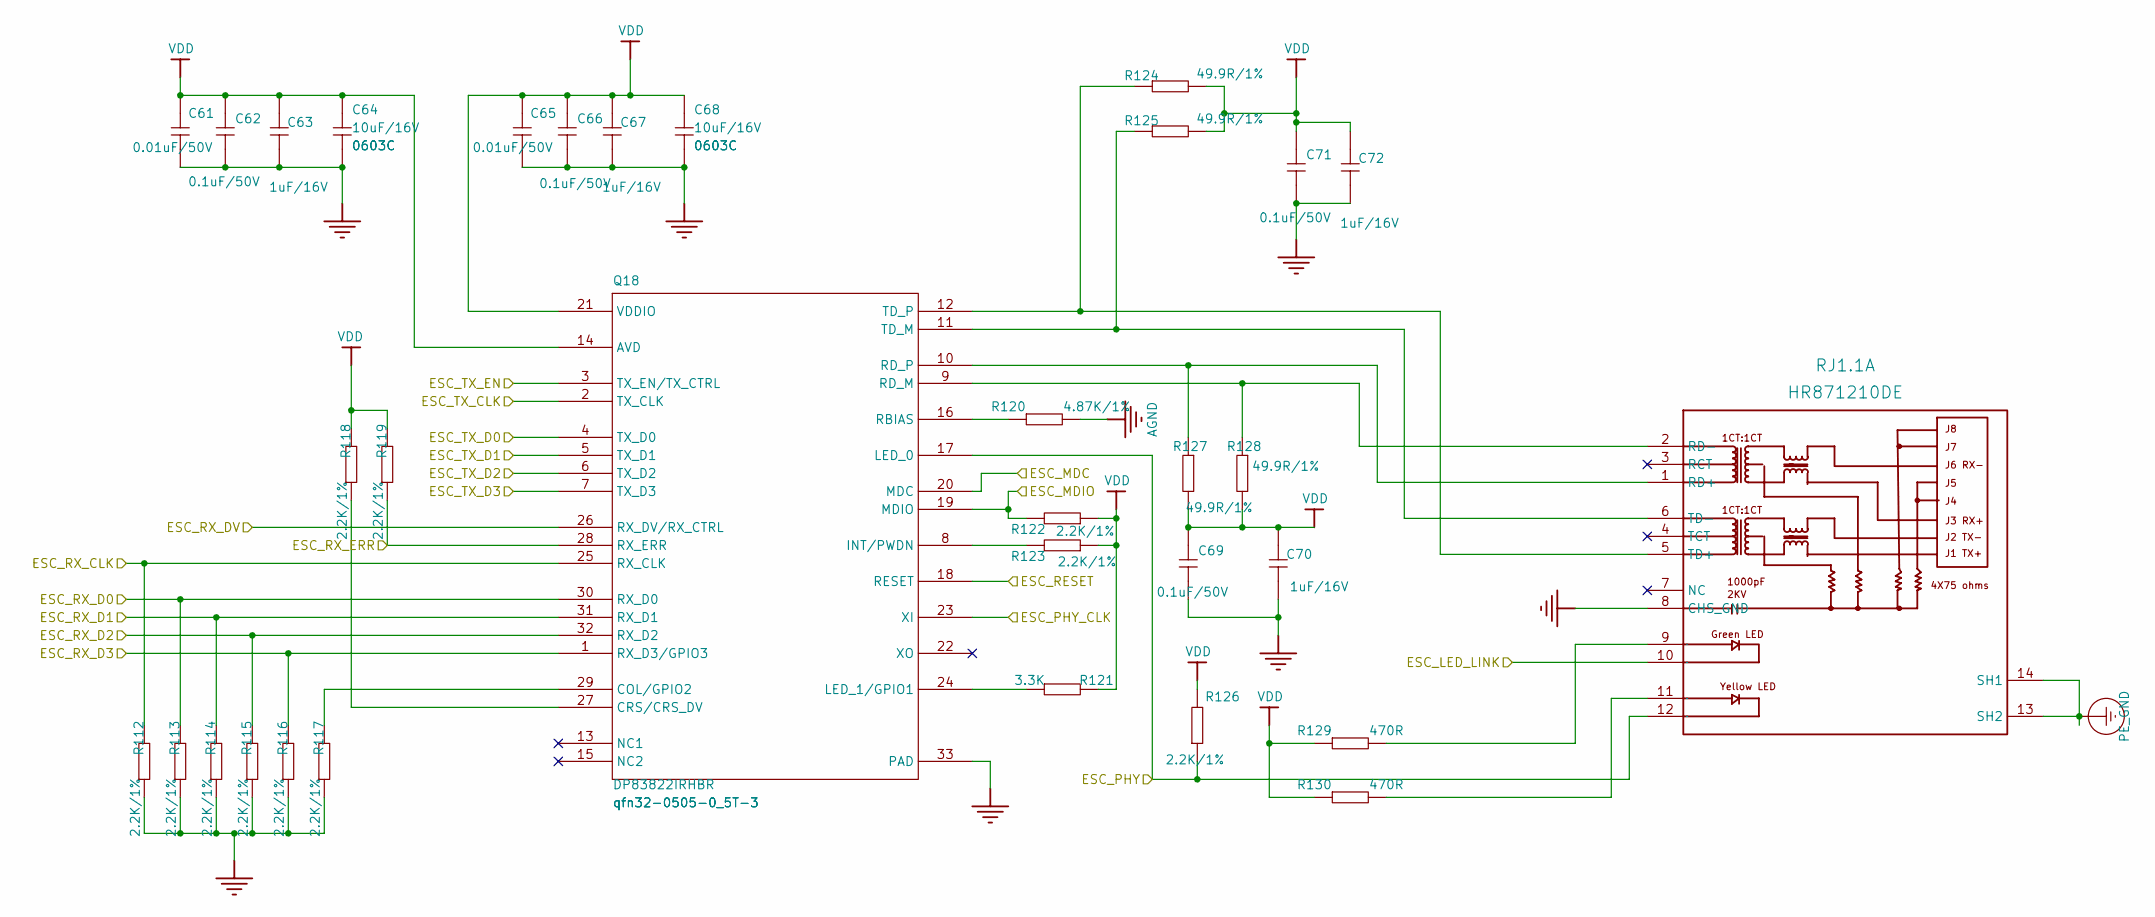
[picture p10: schematic ETHERCAT2.kicad_sch]

Parts:
C61, C65: 0.01uF/50V; C_0603_1608Metric; Part State 已认定
C62, C66, C69, C71: 0.1uF/50V; C_0603_1608Metric; Part State 已认定
C63, C67, C70, C72: 1uF/16V; C_0603_1608Metric; Part State 已认定
C64, C68: 10uF/16V; C_0603_1608Metric; Part State 已认定
Q18: DP83822IRHBR; VQFN-32_L5.0-W5.0-P0.50-TL-EP2.9
R112, R113, R114, R115, R116, R117, R118, R119, R122, R123, R126: 2.2K/1%; R_0603_1608Metric; Part State 已认定
R120: 4.87K/1%; R_0603_1608Metric; Part State 未认定
R121: 3.3K; R_0603_1608Metric; Part State 已认定
R124, R125, R127, R128: 49.9R/1%; R_0603_1608Metric; Part State 已认定
R129, R130: 470R; R_0603_1608Metric; Part State 已认定
RJ1.1: HR871210DE; RJ45-TH_HR871210DE; Manufacturer Part HR871210DE

Connections:
AGND: C61.1, C62.2, C63.1, C64.1, C65.1, C66.2, C67.1, C68.1, C69.2, C70.1, C71.2, C72.1, Q18.33 (PAD), R112.1, R113.1, R114.1, R115.1, R116.1, R117.1, R120.2, RJ1.1.8 (CHS_GND)
ESC_LED_LINK: RJ1.1.10
ESC_MDC: Q18.20 (MDC)
ESC_MDIO: Q18.19 (MDIO), R122.2
ESC_PHY: Q18.17 (LED_0), R126.1, RJ1.1.12
ESC_PHY_CLK: Q18.23 (XI)
ESC_RESET: Q18.18 (RESET)
ESC_RX_CLK: Q18.25 (RX_CLK), R112.2
ESC_RX_D0: Q18.30 (RX_D0), R113.2
ESC_RX_D1: Q18.31 (RX_D1), R114.2
ESC_RX_D2: Q18.32 (RX_D2), R115.2
ESC_RX_D3: Q18.1 (RX_D3/GPIO3), R116.2
ESC_RX_DV: Q18.26 (RX_DV/RX_CTRL)
ESC_RX_ERR: Q18.28 (RX_ERR), R119.1
ESC_TX_CLK: Q18.2 (TX_CLK)
ESC_TX_D0: Q18.4 (TX_D0)
ESC_TX_D1: Q18.5 (TX_D1)
ESC_TX_D2: Q18.6 (TX_D2)
ESC_TX_D3: Q18.7 (TX_D3)
ESC_TX_EN: Q18.3 (TX_EN/TX_CTRL)
unnamed: Q18.8 (INT/PWDN), R123.2
unnamed: Q18.9 (RD_M), R128.1, RJ1.1.2 (RD-)
unnamed: Q18.10 (RD_P), R127.1, RJ1.1.1 (RD+)
unnamed: Q18.11 (TD_M), R125.1, RJ1.1.6 (TD-)
unnamed: Q18.12 (TD_P), R124.1, RJ1.1.5 (TD+)
unnamed: Q18.16 (RBIAS), R120.1
unnamed: Q18.24 (LED_1/GPIO1), R121.1
unnamed: Q18.27 (CRS/CRS_DV), R118.1
unnamed: Q18.29 (COL/GPIO2), R117.2
unnamed: R129.2, RJ1.1.9
unnamed: R130.2, RJ1.1.11
PE_GND: RJ1.1.13 (SH2), RJ1.1.14 (SH1)
VDD: C61.2, C62.1, C63.2, C64.2, C65.2, C66.1, C67.2, C68.2, C69.1, C70.2, C71.1, C72.2, Q18.14 (AVD), Q18.21 (VDDIO), R118.2, R119.2, R121.2, R122.1, R123.1, R124.2, R125.2, R126.2, R127.2, R128.2, R129.1, R130.1
