Acous1/mmlab-12PhaseDrive-388Slave/SlaveDesignFiles/ETHERCAT.kicad_sch

## KiCad design SlaveDesignFiles/ETHERCAT.kicad_sch (2025-04-16)

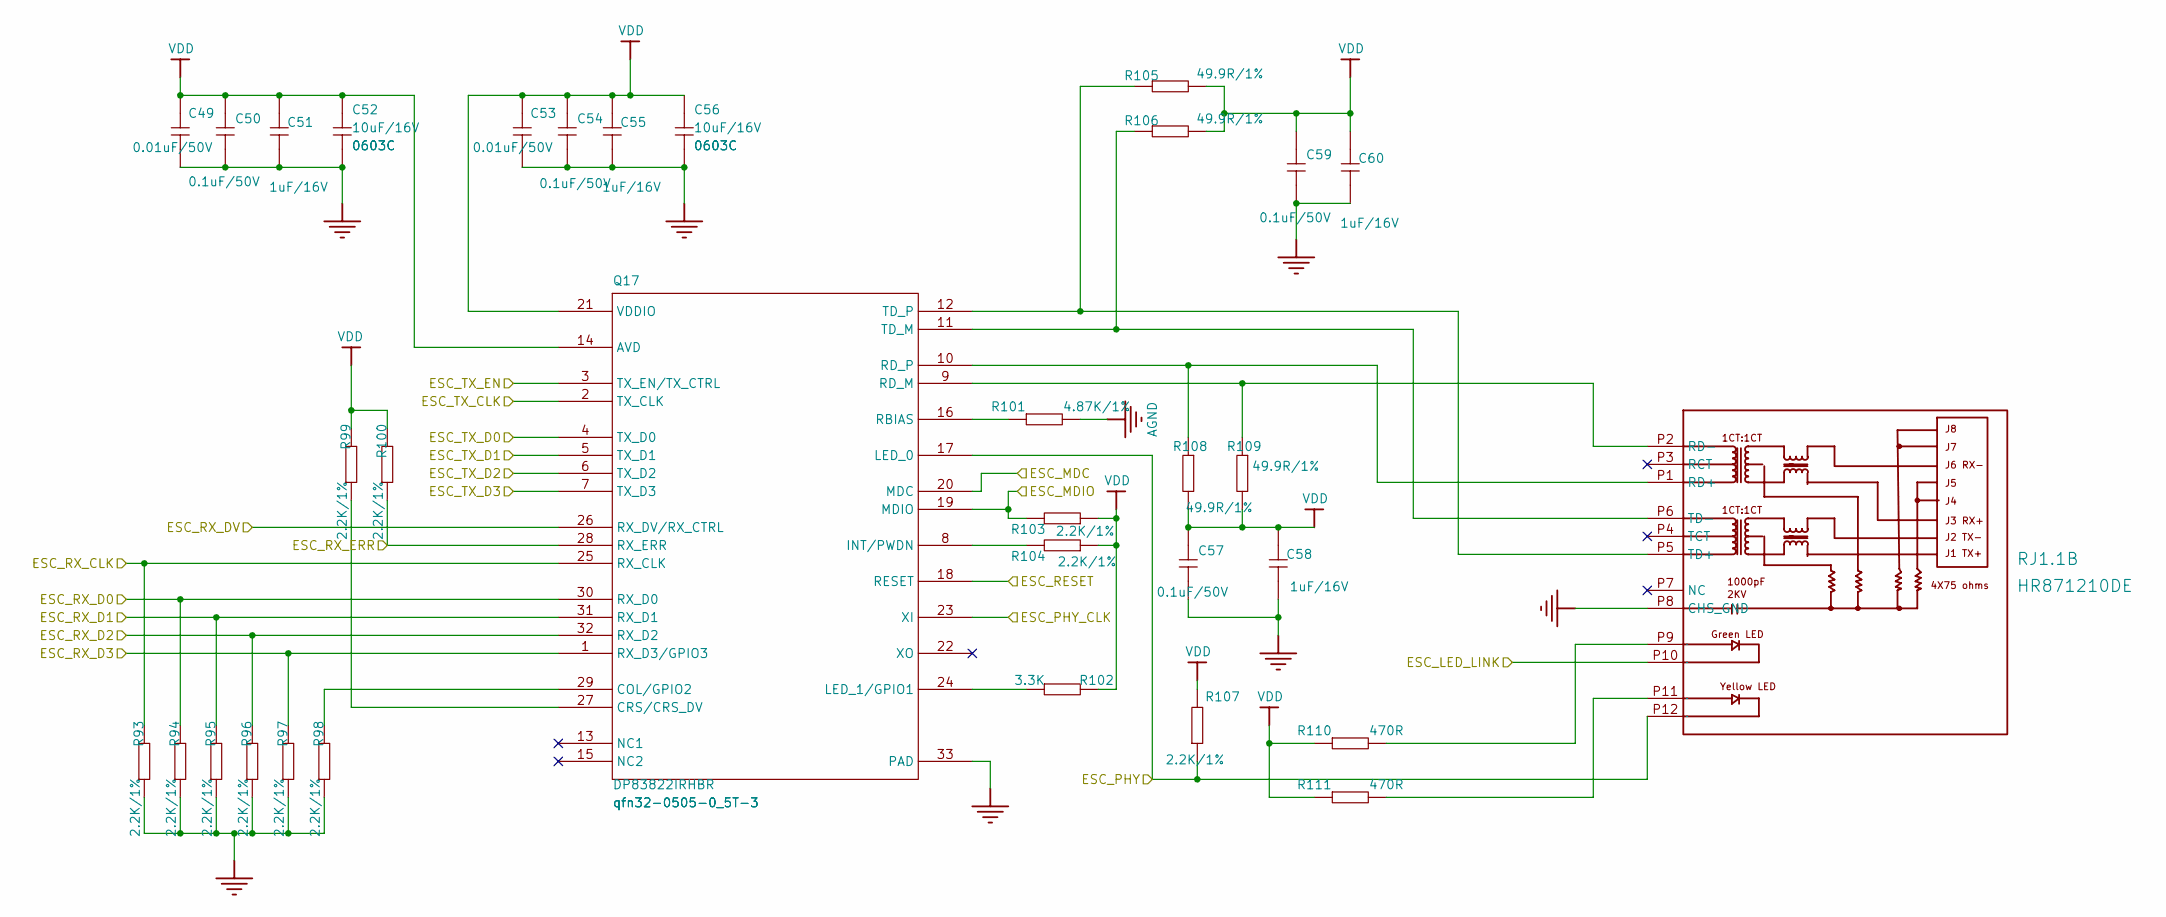
[picture p11: schematic ETHERCAT.kicad_sch]

Parts:
C49, C53: 0.01uF/50V; C_0603_1608Metric; Part State 已认定
C50, C54, C57, C59: 0.1uF/50V; C_0603_1608Metric; Part State 已认定
C51, C55, C58, C60: 1uF/16V; C_0603_1608Metric; Part State 已认定
C52, C56: 10uF/16V; C_0603_1608Metric; Part State 已认定
Q17: DP83822IRHBR; VQFN-32_L5.0-W5.0-P0.50-TL-EP2.9
R93, R94, R95, R96, R97, R98, R99, R100, R103, R104, R107: 2.2K/1%; R_0603_1608Metric; Part State 已认定
R101: 4.87K/1%; R_0603_1608Metric; Part State 未认定
R102: 3.3K; R_0603_1608Metric; Part State 已认定
R105, R106, R108, R109: 49.9R/1%; R_0603_1608Metric; Part State 已认定
R110, R111: 470R; R_0603_1608Metric; Part State 已认定
RJ1.1: HR871210DE; RJ45-TH_HR871210DE; Manufacturer Part HR871210DE

Connections:
AGND: C49.1, C50.2, C51.1, C52.1, C53.1, C54.2, C55.1, C56.1, C57.2, C58.1, C59.2, C60.1, Q17.33 (PAD), R93.1, R94.1, R95.1, R96.1, R97.1, R98.1, R101.2, RJ1.1.P8 (CHS_GND)
ESC_LED_LINK: RJ1.1.P10 (10)
ESC_MDC: Q17.20 (MDC)
ESC_MDIO: Q17.19 (MDIO), R103.2
ESC_PHY: Q17.17 (LED_0), R107.1, RJ1.1.P12 (12)
ESC_PHY_CLK: Q17.23 (XI)
ESC_RESET: Q17.18 (RESET)
ESC_RX_CLK: Q17.25 (RX_CLK), R93.2
ESC_RX_D0: Q17.30 (RX_D0), R94.2
ESC_RX_D1: Q17.31 (RX_D1), R95.2
ESC_RX_D2: Q17.32 (RX_D2), R96.2
ESC_RX_D3: Q17.1 (RX_D3/GPIO3), R97.2
ESC_RX_DV: Q17.26 (RX_DV/RX_CTRL)
ESC_RX_ERR: Q17.28 (RX_ERR), R100.1
ESC_TX_CLK: Q17.2 (TX_CLK)
ESC_TX_D0: Q17.4 (TX_D0)
ESC_TX_D1: Q17.5 (TX_D1)
ESC_TX_D2: Q17.6 (TX_D2)
ESC_TX_D3: Q17.7 (TX_D3)
ESC_TX_EN: Q17.3 (TX_EN/TX_CTRL)
unnamed: Q17.8 (INT/PWDN), R104.2
unnamed: Q17.9 (RD_M), R109.1, RJ1.1.P2 (RD-)
unnamed: Q17.10 (RD_P), R108.1, RJ1.1.P1 (RD+)
unnamed: Q17.11 (TD_M), R106.1, RJ1.1.P6 (TD-)
unnamed: Q17.12 (TD_P), R105.1, RJ1.1.P5 (TD+)
unnamed: Q17.16 (RBIAS), R101.1
unnamed: Q17.24 (LED_1/GPIO1), R102.1
unnamed: Q17.27 (CRS/CRS_DV), R99.1
unnamed: Q17.29 (COL/GPIO2), R98.2
unnamed: R110.2, RJ1.1.P9 (9)
unnamed: R111.2, RJ1.1.P11 (11)
VDD: C49.2, C50.1, C51.2, C52.2, C53.2, C54.1, C55.2, C56.2, C57.1, C58.2, C59.1, C60.2, Q17.14 (AVD), Q17.21 (VDDIO), R99.2, R100.2, R102.2, R103.1, R104.1, R105.2, R106.2, R107.2, R108.2, R109.2, R110.1, R111.1
