Acous1/mmlab-12PhaseDrive-388Slave/SlaveDesignFiles/H485.kicad_sch

## KiCad design SlaveDesignFiles/H485.kicad_sch (2025-04-16)

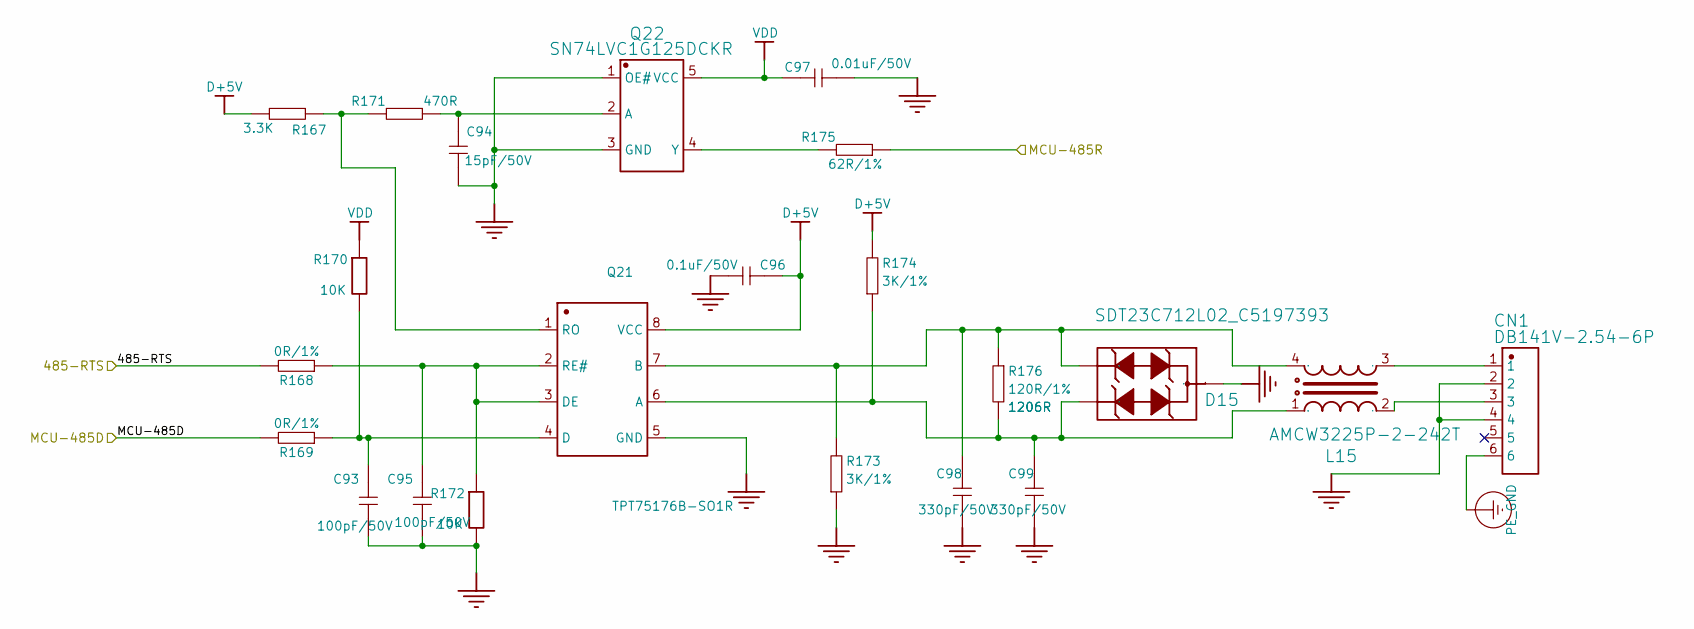
[picture p12: schematic H485.kicad_sch]

Parts:
C93, C95: 100pF/50V; C_0603_1608Metric; Part State 已认定
C94: 15pF/50V; C_0603_1608Metric; Part State 已认定
C96: 0.1uF/50V; C_0603_1608Metric; Part State 已认定
C97: 0.01uF/50V; C_0603_1608Metric; Part State 已认定
C98, C99: 330pF/50V; C_0603_1608Metric; Part State 已认定
CN1: DB141V-2.54-6P; CONN-TH_6P-P2.54_DIBO_DB141V-2.54-6P; Manufacturer Part DB141V-2.54-6P-GN
D15: SDT23C712L02_C5197393; SOT-23-3_L2.9-W1.3-P1.90-LS2.4-BR; Manufacturer Part SDT23C712L02
L15: AMCW3225P-2-242T; FILTER-SMD_4P-L3.2-W2.5-BL_WCM3225XXXX; Manufacturer Part AMCW3225P-2-242T
Q21: TPT75176B-SO1R; SOP-8_L4.9-W3.9-P1.27-LS6.0-BL; Manufacturer Part TPT75176B-SO1R
Q22: SN74LVC1G125DCKR; SOT-353_L2.2-W1.4-P0.65-LS2.4-BR; Manufacturer Part SN74LVC1G125DCKR
R167: 3.3K; R_0603_1608Metric; Part State 已认定
R168, R169: 0R/1%; R_0603_1608Metric; Part State 已认定
R170, R172: 10K; R_0805_2012Metric
R171: 470R; R_0603_1608Metric; Part State 已认定
R173, R174: 3K/1%; R_0603_1608Metric; Part State 未认定
R175: 62R/1%; R_0603_1608Metric; Part State 已认定
R176: 120R/1%; R_1206_3216Metric; Part State 已认定

Connections:
485-RTS: R168.2
AGND: C93.2, C94.1, C95.2, C96.2, C97.1, C98.2, C99.2, CN1.2, CN1.4, D15.3, Q21.5 (GND), Q22.1 (OE#), Q22.3 (GND), R172.2, R173.1
D+5V: C96.1, Q21.8 (VCC), R167.1, R174.2
MCU-485D: R169.2
MCU-485R: R175.1
unnamed: C93.1, Q21.4 (D), R169.1, R170.2
unnamed: C94.2, Q22.2 (A), R171.2
unnamed: C95.1, Q21.2 (RE#), Q21.3 (DE), R168.1, R172.1
unnamed: C98.1, D15.1, L15.4, Q21.7 (B), R173.2, R176.1
unnamed: C99.1, D15.2, L15.1, Q21.6 (A), R174.1, R176.2
unnamed: CN1.1, L15.3
unnamed: CN1.3, L15.2
unnamed: Q21.1 (RO), R167.2, R171.1
unnamed: Q22.4 (Y), R175.2
PE_GND: CN1.6
VDD: C97.2, Q22.5 (VCC), R170.1
