Acous1/mmlab-12PhaseDrive-388Slave/SlaveDesignFiles/IPM.kicad_sch

## KiCad design SlaveDesignFiles/IPM.kicad_sch (2025-04-16)

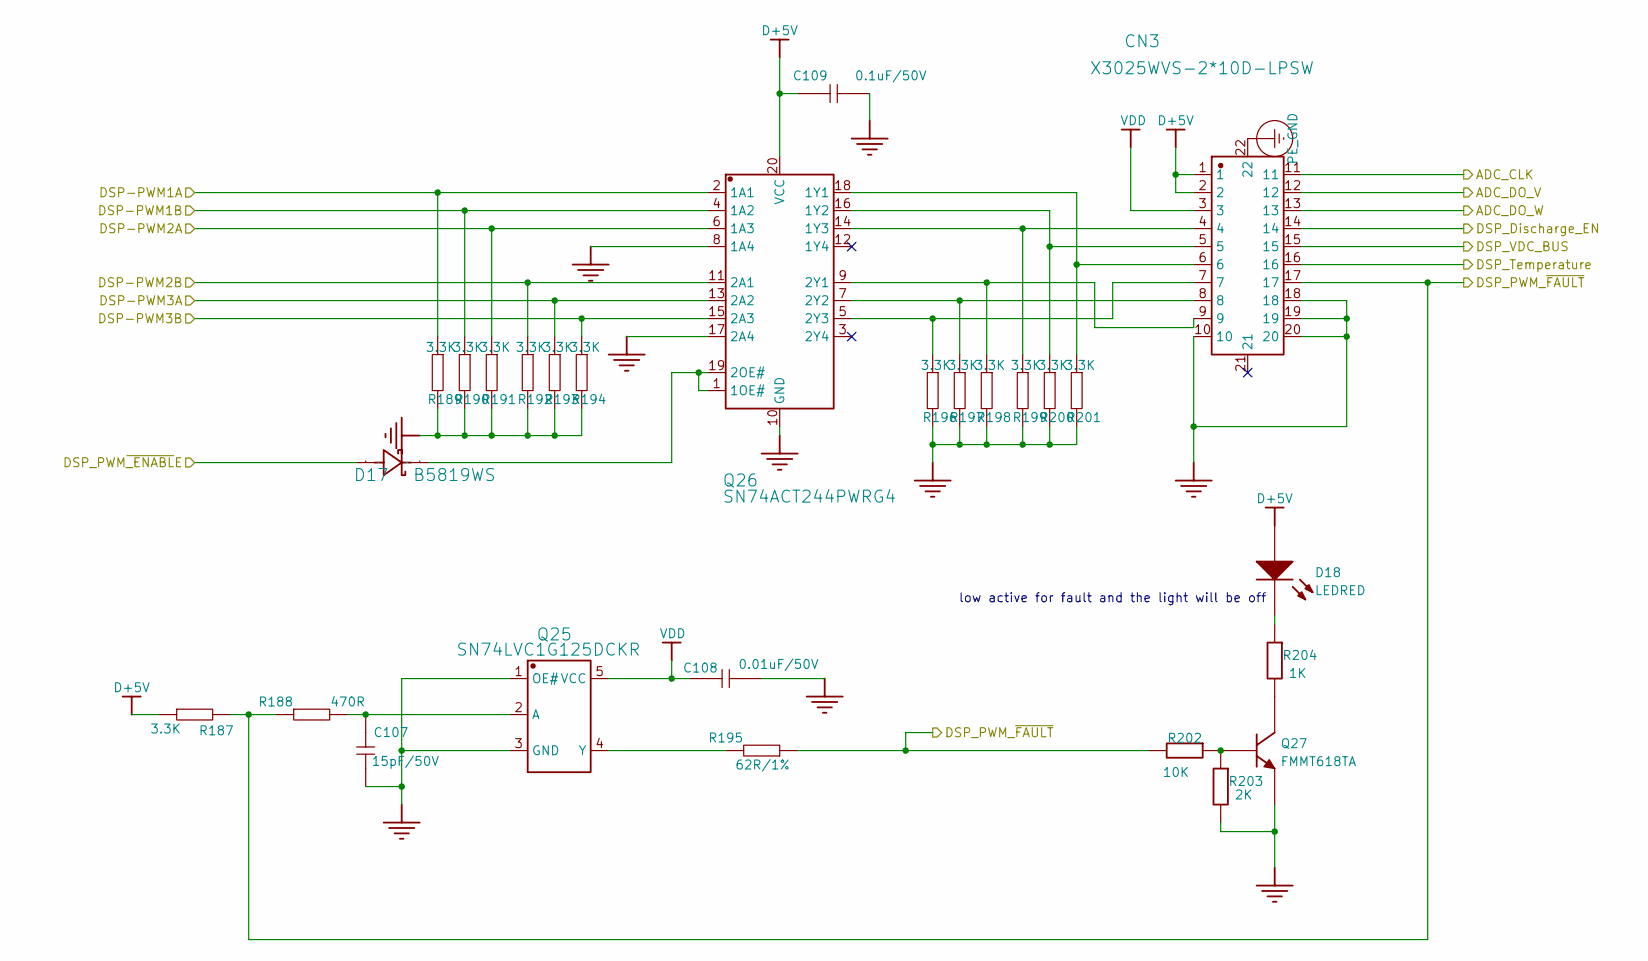
[picture p13: schematic IPM.kicad_sch]

Parts:
C107: 15pF/50V; C_0603_1608Metric; Part State 已认定
C108: 0.01uF/50V; C_0603_1608Metric; Part State 已认定
C109: 0.1uF/50V; C_0603_1608Metric; Part State 已认定
CN3: X3025WVS-2*10D-LPSW; CONN-SMD_20P-P3.00_X3025WVS-2-10D-LPSW; Manufacturer Part X3025WVS-2x10D-LPSW
D17: B5819WS; SOD-323_L1.7-W1.3-LS2.5-FD; Manufacturer Part B5819WS
D18: LEDRED; LED_0805_2012Metric
Q25: SN74LVC1G125DCKR; SOT-353_L2.2-W1.4-P0.65-LS2.4-BR; Manufacturer Part SN74LVC1G125DCKR
Q26: SN74ACT244PWRG4; TSSOP-20_L6.5-W4.4-P0.65-LS6.4-BL; Manufacturer Part SN74ACT244PWR
Q27: FMMT618TA; SOT-23
R187, R189, R190, R191, R192, R193, R194, R196, R197, R198, R199, R200, R201: 3.3K; R_0603_1608Metric; Part State 已认定
R188: 470R; R_0603_1608Metric; Part State 已认定
R195: 62R/1%; R_0603_1608Metric; Part State 已认定
R202: 10K; R_0805_2012Metric
R203: 2K; R_0805_2012Metric
R204: 1K; R_0805_2012Metric

Connections:
ADC_CLK: CN3.11
ADC_DO_V: CN3.12
ADC_DO_W: CN3.13
AGND: C107.1, C108.1, C109.2, CN3.10, CN3.18, CN3.19, CN3.20, Q25.1 (OE#), Q25.3 (GND), Q26.8 (1A4), Q26.10 (GND), Q26.17 (2A4), Q27.2 (E), R189.2, R190.2, R191.2, R192.2, R193.2, R194.2, R196.2, R197.2, R198.2, R199.2, R200.2, R201.2, R203.2
D+5V: C109.1, CN3.1, CN3.2, D18.1 (A), Q26.20 (VCC), R187.1
DSP-PWM1A: Q26.2 (1A1), R189.1
DSP-PWM1B: Q26.4 (1A2), R190.1
DSP-PWM2A: Q26.6 (1A3), R191.1
DSP-PWM2B: Q26.11 (2A1), R192.1
DSP-PWM3A: Q26.13 (2A2), R193.1
DSP-PWM3B: Q26.15 (2A3), R194.1
DSP_Discharge_EN: CN3.14
DSP_PWM_~FAULT: CN3.17, R187.2, R188.1, R195.1, R202.2
DSP_PWM~_ENABLE: D17.1 (A)
DSP_Temperature: CN3.16
DSP_VDC_BUS: CN3.15
unnamed: C107.2, Q25.2 (A), R188.2
unnamed: CN3.4, Q26.14 (1Y3), R199.1
unnamed: CN3.5, Q26.16 (1Y2), R200.1
unnamed: CN3.6, Q26.18 (1Y1), R201.1
unnamed: CN3.7, Q26.5 (2Y3), R196.1
unnamed: CN3.8, Q26.7 (2Y2), R197.1
unnamed: CN3.9, Q26.9 (2Y1), R198.1
unnamed: D17.2 (K), Q26.1 (1OE#), Q26.19 (2OE#)
unnamed: D18.2 (K), R204.2
unnamed: Q25.4 (Y), R195.2
unnamed: Q27.1 (B), R202.1, R203.1
unnamed: Q27.3 (C), R204.1
PE_GND: CN3.22
VDD: C108.2, CN3.3, Q25.5 (VCC)

Notes on the sheet:
low active for fault and the light will be off
