Acous1/mmlab-12PhaseDrive-388Slave/SlaveDesignFiles/sheet1.kicad_sch

## KiCad design SlaveDesignFiles/sheet1.kicad_sch (2025-04-16)

Schematic: sheet1.kicad_sch

Parts:
C119, C120: 103; C_0805_2012Metric
C121, C122, C124, C126, C127, C134, C135, C140, C142, C145: 0.1uF/50V; C_0603_1608Metric; Part State 已认定
C123, C125: 1000pF/50V; C_0603_1608Metric; Part State 已认定
C128, C129: 4700pF/50V; C_0603_1608Metric; Part State 已认定
C130, C131, C132, C133: 33pF/100V; R_0603_1608Metric; Part State 已认定
C136, C138, C143: 10uF/16V; C_0603_1608Metric; Part State 已认定
C137, C139, C141: 100pF/50V; C_0603_1608Metric; Part State 已认定
C144: 100uF; CAP-TH_BD6.3-P2.50-D1.0-FD; Manufacturer Part ERS1VM101E12OT
CN7, CN8: DB141V-2.54-6P; CONN-TH_6P-P2.54_DIBO_DB141V-2.54-6P; Manufacturer Part DB141V-2.54-6P-GN
D25, D26, D27, D30, D34, D40: LEDRED; LED_0805_2012Metric
D28, D29, D35, D36, D38, D39: BZX84C3V3; SOT-23-3_L2.9-W1.6-P1.90-LS2.8-BR; Manufacturer Part BZX84C3V3
D31, D37: SK36A-LTP; SMA_L4.3-W2.6-LS5.2-RD; Manufacturer Part SK36A-LTP
D32, D33: SDT23C712L02_C5197393; SOT-23-3_L2.9-W1.3-P1.90-LS2.4-BR; Manufacturer Part SDT23C712L02
D41: XL-1608PGC-06; LED0603-RD_GREEN; Manufacturer Part XL-1608PGC-06
DSUB1: DDMRH15PFE006; DSUB-TH_15P-P2.29-H-F_DDMRH15PFE006; Manufacturer Part D-DMRH15PF-E006
DSUB2, DSUB3, DSUB4, DSUB5: DMR-9S; DSUB-TH_DMR-9S; Manufacturer Part D-DMR009PF-D002
J1, J2: Conn_02x02_Counter_Clockwise; PinSocket_2x02_P2.54mm_Vertical
J3, J4, J5, J6, J8: 2.54-2*5; HDR-TH_10P-P2.54-V-F-R2-C5-S2.54; Manufacturer Part 2.54-2*5
J7: PM2.54-2*10; HDR-TH_20P-P2.54-V-F-R2-C10-S2.54; Manufacturer Part PM2.54-2*10
L17, L18, L19: AMCW3225P-2-242T; FILTER-SMD_4P-L3.2-W2.5-BL_WCM3225XXXX; Manufacturer Part AMCW3225P-2-242T
M1, M2, M3, M4, M5, M6, M7, M8: Conn_01x01_Socket; M3
Q37, Q38, Q39, Q41: FMMT618TA; SOT-23
Q40: SN74LVC14APWRG4; TSSOP-14_L5.0-W4.4-P0.65-LS6.4-BL; Manufacturer Part SN74LVC14APWR
Q42, Q43: TPT1042VQ-SO1R-S; SOP-8_L4.9-W3.9-P1.27-LS6.0-BL; Part State 已认定
Q44: CP2102N-A02-GQFN28R; QFN-28_L5.0-W5.0-P0.50-TL-EP3.3; Manufacturer Part CP2102N-A02-GQFN28R
Q45: AMS1117-3.3; SOT-223-3_TabPin2
Q46: TYPEC-304-ACP16; USB-C-SMD_TYPE-C-16P-1; Manufacturer Part TYPEC-304-ACP16
Q47: AT24C16C-SSHM-T; SOIC-8_L4.9-W3.9-P1.27-LS6.0-BL; Manufacturer Part AT24C16C-SSHM-T
Q48: SRV05-4HTG; SOT-23-6_L2.9-W1.6-P0.95-LS2.8-BL; Manufacturer Part SRV05-4HTG
R259, R262, R265, R272, R287, R288, R289, R290, R297: 10K; R_0805_2012Metric
R260, R263, R266, R273: 2K; R_0805_2012Metric
R261, R264, R267, R270, R271, R274: 1K; R_0805_2012Metric
R268, R269: 100R; R_0805_2012Metric
R275, R276, R277, R278, R279, R280, R296, R299: 100R/1%; R_1206_3216Metric; Part State 已认定
R281, R282, R295, R301, R302, R303, R304: 4.7K/1%; R_0603_1608Metric; Part State 已认定
R283, R284, R285, R286: 60.4R/1%; R_1206_3216Metric; Part State 已认定
R291, R293: 1.69K/1%; R_0805_2012Metric
R292, R294: 3.3K/1%; R_0805_2012Metric
R298: 470R; R_0603_1608Metric; Part State 已认定
R300: 3.3K; R_0603_1608Metric; Part State 已认定
R305, R306: 49.9K/1%; R_0603_1608Metric; Part State 未认定
R307, R308: 1.2K/1%; R_0603_1608Metric; Part State 已认定
TP1, TP2: TestPoint; TestPoint_Loop_D2.60mm_Drill1.4mm_Beaded
U1, U2, U3, U4, U5, U6: X1321FVS-2X20-C43D48; HDR-SMD_40P-P1.27-V-F-R2-C20-LS4.8; Manufacturer Part X1321FVS-2x20-C43D48
U7: PM254-2-15-Z-8.5; HDR-TH_30P-P2.54-V-F-R2-C15-S2.54; Manufacturer Part PM254-2-15-Z-8.5
X1, X2: 20MHz; OSC-SMD_4P-L2.5-W2.0-BL; Manufacturer Part ECS-2520S33-250-FN-TR

Connections:
485_RTS_1: U6.3 (P138)
485_RTS_2: U6.17 (P45)
ADC_CLK_X1: U6.13 (P49), X1.3 (Output)
ADC_CLK_X2: U6.35 (P80), X2.3 (Output)
ADC_DO_V_1: U4.36 (P122)
ADC_DO_V_2: U4.21 (P126)
ADC_DO_V_3: U6.36 (P79)
ADC_DO_V_4: U6.32 (P75)
ADC_DO_W_1: U4.34 (P124)
ADC_DO_W_2: U4.24 (P128)
ADC_DO_W_3: U7.12 (P26)
ADC_DO_W_4: U6.34 (P77)
AGND: C119.1, C120.1, C121.2, C122.2, C123.1, C124.2, C125.1, C126.2, C127.2, C128.1, C129.1, C130.1, C131.2, C132.1, C133.2, C134.2, C135.2, C136.1, C137.1, C138.1, C139.1, C140.2, C141.1, C142.2, C143.1, C144.2, C145.1, CN7.2, CN7.4, CN8.2, CN8.4, D28.1 (A), D29.1 (A), D32.3, D33.3, D35.1 (A), D36.1 (A), D38.1 (A), D39.1 (A), DSUB1.8, DSUB1.9, DSUB2.9, DSUB3.9, DSUB4.9, DSUB5.9, J1.2, J2.2, J3.1, J3.2, J3.3, J3.4, J3.5, J3.6, J4.7, J4.8, J4.9, J4.10, J5.3, J5.4, J5.9, J5.10, J6.3, J6.4, J6.9, J6.10, J7.5, J7.6, J7.7, J7.8, J8.7, J8.8, J8.9, J8.10, Q37.2 (E), Q38.2 (E), Q39.2 (E), Q40.7 (GND), Q41.2 (E), Q42.2 (GND), Q43.2 (GND), Q44.3 (GND), Q44.29 (EP), Q45.1 (GND), Q46.A1B12 (GND), Q46.B1A12 (GND), Q47.1 (NC), Q47.2 (NC), Q47.3 (NC), Q47.4 (GND), Q47.7 (WP), Q48.2 (GND), R260.2, R263.2, R266.2, R270.2, R271.2, R273.2, R281.1, R282.1, R292.1, R294.1, R301.2, R302.1, R305.1, R306.1, U1.2 (GND), U1.13 (GND), U1.32 (GND), U1.39 (GND), U2.7 (GND), U2.8 (GND), U2.9 (GND), U2.10 (GND), U2.17 (GND), U2.18 (GND), U2.19 (GND), U2.20 (GND), U2.21 (GND), U2.22 (GND), U2.23 (GND), U2.24 (GND), U2.39 (GND), U3.2 (GND), U3.23 (GND), U3.24 (GND), U3.33 (GND), U3.34 (GND), U3.35 (GND), U3.36 (GND), U3.37 (GND), U3.38 (GND), U3.39 (GND), U3.40 (GND), U4.5 (GND), U4.6 (GND), U4.17 (GND), U4.20 (GND), U4.39 (GND), U5.2 (GND), U5.13 (GND), U5.16 (GND), U5.17 (GND), U5.39 (GND), U6.2 (GND), U6.7 (GND), U6.23 (GND), U7.2 (GND), U7.18 (GND), U7.30 (GND), X1.2 (Gnd), X2.2 (Gnd)
BootFromFlash1: R293.1, R294.2, U6.27 (P72)
BootFromFlash2: R291.1, R292.2, U2.34 (P84)
CAN_H1: C132.2, CN8.1, D33.1, L18.3, R285.2
CAN_H2: C130.2, CN7.1, D32.1, L17.3, R283.2
CAN_L1: C133.1, CN8.3, D33.2, L18.2, R286.1
CAN_L2: C131.1, CN7.3, D32.2, L17.2, R284.1
D+5V: C126.1, C127.1, C138.2, C140.1, D25.1 (A), D26.1 (A), D27.1 (A), D30.1 (A), D31.1 (K), D37.1 (K), DSUB1.1, DSUB2.1, DSUB3.1, DSUB4.1, DSUB5.1, J7.11, J7.12, J7.13, J7.14, Q42.3 (VCC), Q43.3 (VCC), Q44.7 (VREGIN), Q44.8 (VBUS), Q45.3 (VI), Q48.5 (VCC), R291.2, R293.2, R295.2, U1.1 (5V), U2.11 (5V), U2.12 (5V), U2.13 (5V), U2.14 (5V), U2.15 (5V), U2.16 (5V), U3.1 (5V), U3.29 (5V), U3.30 (5V), U3.31 (5V), U3.32 (5V), U4.40 (5V), U5.1 (5V), U5.40 (5V), U6.1 (5V)
DI-1-DSP-3.3V: C119.2, D28.3 (K), R269.1, R270.1, U1.34 (P120)
DI-2-DSP-3.3V: C120.2, D29.3 (K), R268.1, R271.1, U1.31 (P121)
DSP-PWM1A: U3.15 (P145)
DSP-PWM1B: U3.21 (P146)
DSP-PWM2A: U2.37 (P147)
DSP-PWM2B: U7.7 (P3)
DSP-PWM3A: U5.19 (P149)
DSP-PWM3B: U1.38 (P150)
DSP-PWM4A: U1.40 (P151)
DSP-PWM4B: U5.26 (P152)
DSP-PWM5A: U5.24 (P153)
DSP-PWM5B: U5.20 (P154)
DSP-PWM6A: U5.28 (P155)
DSP-PWM6B: U1.14 (P11)
DSP-PWM7A: U7.4 (P12)
DSP-PWM7B: U7.29 (P13)
DSP-PWM8A: U2.27 (P14)
DSP-PWM8B: U2.26 (P15)
DSP-PWM9A: U1.12 (P16)
DSP-PWM9B: U1.7 (P17)
DSP-PWM10A: U1.11 (P18)
DSP-PWM10B: U1.10 (P19)
DSP-PWM11A: U7.1 (P20)
DSP-PWM11B: U7.3 (P21)
DSP-PWM12A: U5.11 (P22)
DSP-PWM12B: U5.14 (P23)
DSP_A_CAN_EN: R280.1, U7.8 (P2)
DSP_A_CAN_RX: R279.1, U7.5
DSP_A_CAN_TX: R278.1, U7.6 (P4)
DSP_B_CAN_EN: R277.1, U7.15 (P9)
DSP_B_CAN_RX: R276.1, U7.13 (P10)
DSP_B_CAN_TX: R275.1, U7.17 (P8)
DSP_Discharge1_EN: U7.11 (P27)
DSP_Discharge2_EN: U3.3 (P28)
DSP_Discharge3_EN: U5.22 (P143)
DSP_Discharge4_EN: U5.21 (P144)
DSP_PWM1_~FAULT: U5.10 (P93)
DSP_PWM1~_ENABLE: R289.1, U6.39 (P85)
DSP_PWM2_~FAULT: U5.12 (P94)
DSP_PWM2~_ENABLE: R290.1, U5.5 (P88)
DSP_PWM3_~FAULT: U3.9 (P109)
DSP_PWM3~_ENABLE: R287.2, U5.6 (P89)
DSP_PWM4_~FAULT: U3.10 (P117)
DSP_PWM4~_ENABLE: R288.2, U5.7 (P90)
DSP_Temperature1: U7.20 (B4)
DSP_Temperature2: U7.22 (B5)
DSP_Temperature3: U7.21 (C2)
DSP_Temperature4: U7.19 (C3)
DSP_VDC_BUS1: U7.26 (A2)
DSP_VDC_BUS2: U7.24 (A3)
DSP_VDC_BUS3: U7.27 (B2)
DSP_VDC_BUS4: U7.28 (B3)
ESC_I2C_SCL: Q47.6 (SCL), R303.1, U6.19 (P41)
ESC_I2C_SDA: Q47.5 (SDA), R304.1, U6.22 (P40)
ESC_LED_ERR: D40.2 (K), R305.2, U1.24 (P60)
ESC_LED_LINK0: U1.26 (P58)
ESC_LED_LINK1: U1.23 (P59)
ESC_LED_RUN: D41.1 (K), R306.2, U1.21 (P61)
ESC_MDC: U6.18 (P46)
ESC_MDIO: U6.15 (P47)
ESC_PHY0: U5.23 (P148)
ESC_PHY1: U1.16 (P68)
ESC_PHY_CLK: U6.16 (P48)
ESC_RESET: U6.31 (P76)
ESC_RX0_CLK: U5.33 (P163)
ESC_RX0_D0: U5.36 (P165)
ESC_RX0_D1: U5.37 (P166)
ESC_RX0_D2: U5.38 (P167)
ESC_RX0_D3: U5.35 (P168)
ESC_RX0_DV: U5.30 (P162)
ESC_RX0_ERR: U5.34 (P164)
ESC_RX1_CLK: U3.16 (P137)
ESC_RX1_D0: U3.18 (P139)
ESC_RX1_D1: U3.20 (P140)
ESC_RX1_D2: U3.14 (P141)
ESC_RX1_D3: U3.22 (P142)
ESC_RX1_DV: U3.12 (P136)
ESC_RX1_ERR: U6.28 (P71)
ESC_TX0_CLK: U5.29 (P157)
ESC_TX0_D0: U5.27 (P158)
ESC_TX0_D1: U5.31 (P159)
ESC_TX0_D2: U5.32 (P160)
ESC_TX0_D3: U5.25 (P161)
ESC_TX0_EN: U5.18 (P156)
ESC_TX1_CLK: U4.27 (P130)
ESC_TX1_D0: U4.28 (P131)
ESC_TX1_D1: U6.5 (P132)
ESC_TX1_D2: U6.6 (P134)
ESC_TX1_D3: U6.4 (P135)
ESC_TX1_EN: U4.30 (P129)
FSI_RXA_CLK: J8.5, U4.23 (P105)
FSI_RXA_D0: J8.1, U1.37 (P103)
FSI_RXA_D1: J8.3, U1.3 (P104)
FSI_RXB_CLK: J4.5, U4.38 (P112)
FSI_RXB_D0: J4.1, U4.35 (P110)
FSI_RXB_D1: J4.3, U4.32 (P111)
FSI_TXA_CLK: J8.6, U1.6 (P102)
FSI_TXA_D0: J8.2, U1.4 (P100)
FSI_TXA_D1: J8.4, U1.5 (P101)
FSI_TXB_CLK: J4.6, U4.31 (P108)
FSI_TXB_D0: J4.2, U4.22 (P106)
FSI_TXB_D1: J4.4, U2.28 (P107)
HALL_U: Q40.2 (1Y), U2.38 (P133)
HALL_UY: Q40.1 (1A)
HALL_U_H: DSUB1.3
HALL_U_L: DSUB1.2
HALL_V: Q40.4 (2Y), U2.36 (P42)
HALL_VY: Q40.3 (2A)
HALL_V_H: DSUB1.6
HALL_V_L: DSUB1.7
HALL_W: Q40.6 (3Y), U2.35 (P43)
HALL_WY: Q40.5 (3A)
HALL_W_H: DSUB1.11
HALL_W_L: DSUB1.12
Header-D+5V: D31.2 (A), J3.7, J3.8, J3.9, J3.10
LED1: R272.2, U4.29 (P113)
LED2: R265.2, U4.37 (P114)
LED3: R262.2, U4.25 (P118)
LED4: R259.2, U4.19 (P125)
MCU_485D_1: U5.4 (P86)
MCU_485D_2: U6.24 (P38)
MCU_485R_1: U5.3 (P87)
MCU_485R_2: U6.21 (P39)
MCU_CLK_B1: U3.6 (P33)
MCU_CLK_B2: U3.8 (P36)
MCU_CLK_D1: U6.10 (P32)
MCU_CLK_D2: U6.9 (P37)
MCU_EnDI_B1: U7.16 (P24)
MCU_EnDI_B2: U1.19 (P63)
MCU_EnDI_D1: U3.5 (P30)
MCU_EnDI_D2: U5.8 (P91)
MCU_EnDO_B1: U7.14 (P25)
MCU_EnDO_B2: U1.20 (P64)
MCU_EnDO_D1: U6.8 (P31)
MCU_EnDO_D2: U5.9 (P92)
MCU_PwrEn_B1: U2.30 (P7)
MCU_PwrEn_B2: U2.33 (P95)
MCU_PwrEn_D1: U6.12 (P52)
MCU_PwrEn_D2: U6.40 (P83)
MCU_TxEn_B: U2.31 (P96)
MCU_TxEn_D: U2.32 (P97)
MQEP1A: Q40.12 (6Y), U6.14 (P50)
MQEP1AY: Q40.13 (6A)
MQEP1A_H: DSUB1.15
MQEP1A_L: DSUB1.10
MQEP1B: Q40.10 (5Y), U6.11 (P51)
MQEP1BY: Q40.11 (5A)
MQEP1B_H: DSUB1.5
MQEP1B_L: DSUB1.4
MQEP1Z: Q40.8 (4Y), U1.29 (P53)
MQEP1ZY: Q40.9 (4A)
MQEP1Z_H: DSUB1.13
MQEP1Z_L: DSUB1.14
MSCLA: D35.3 (K), J5.5, J5.6, U7.9 (P1)
MSCLB: D38.3 (K), J6.5, J6.6, U6.26 (P69)
MSDAA: D36.3 (K), J5.7, J5.8, U7.10 (P0)
MSDAB: D39.3 (K), J6.7, J6.8, U1.18 (P66)
unnamed: C123.2, Q42.8 (S), R277.2, R281.2
unnamed: C125.2, Q43.8 (S), R280.2, R282.2
unnamed: C128.2, R283.1, R284.2
unnamed: C129.2, R285.1, R286.2
unnamed: C136.2, Q44.6 (VDD)
unnamed: C137.2, R296.2, R297.2, R298.1
unnamed: C139.2, Q44.25 (RXD), R298.2
unnamed: C141.2, Q44.26 (TXD), R299.2, R300.1
unnamed: D25.2 (K), R261.2
unnamed: D26.2 (K), R264.2
unnamed: D27.2 (K), R267.2
unnamed: D30.2 (K), R274.2
unnamed: D34.1 (A), R295.1
unnamed: D34.2 (K), Q44.12 (SUSPEND)
unnamed: D40.1 (A), R307.1
unnamed: D41.2 (A), R308.1
unnamed: J1.3, J1.4, R269.2
unnamed: J2.3, J2.4, R268.2
unnamed: Q37.1 (B), R259.1, R260.1
unnamed: Q37.3 (C), R261.1
unnamed: Q38.1 (B), R262.1, R263.1
unnamed: Q38.3 (C), R264.1
unnamed: Q39.1 (B), R265.1, R266.1
unnamed: Q39.3 (C), R267.1
unnamed: Q41.1 (B), R272.1, R273.1
unnamed: Q41.3 (C), R274.1
unnamed: Q42.1 (TXD), R275.2
unnamed: Q42.4 (RXD), R276.2
unnamed: Q43.1 (TXD), R278.2
unnamed: Q43.4 (RXD), R279.2
unnamed: Q46.A5 (CC1), R301.1
unnamed: Q46.B5 (CC2), R302.2
unnamed: TP1.1, U2.1 (3.3V), U2.3 (3.3V), U2.5 (3.3V)
unnamed: TP2.1, U2.2 (3.3V), U2.4 (3.3V), U2.6 (3.3V)
PE_GND: CN7.6, CN8.6, DSUB1.17, DSUB2.10 (MH1), DSUB2.11 (MH2), DSUB3.10 (MH1), DSUB3.11 (MH2), DSUB4.10 (MH1), DSUB4.11 (MH2), DSUB5.10 (MH1), DSUB5.11 (MH2), J7.19, J7.20, M1.1, M2.1, M3.1, M4.1, M5.1, M6.1, M7.1, M8.1, Q46.EP
RS485-C+_1: DSUB5.5
RS485-C+_2: DSUB2.5
RS485-C+_3: DSUB3.5
RS485-C+_4: DSUB4.5
RS485-C-_1: DSUB5.4
RS485-C-_2: DSUB2.4
RS485-C-_3: DSUB3.4
RS485-C-_4: DSUB4.4
RS485-D+_1: DSUB5.3
RS485-D+_2: DSUB2.3
RS485-D+_3: DSUB3.3
RS485-D+_4: DSUB4.3
RS485-D-_1: DSUB5.2
RS485-D-_2: DSUB2.2
RS485-D-_3: DSUB3.2
RS485-D-_4: DSUB4.2
SPI_A_CK_HS: J7.2, U1.28 (P56)
SPI_A_MI_HS: J7.4, U1.27 (P55)
SPI_A_MO_HS: J7.1, U1.30 (P54)
U4+: L17.4, Q42.7 (CANH)
U4-: L17.1, Q42.6 (CANL)
U44+: L18.4, Q43.7 (CANH)
U44-: L18.1, Q43.6 (CANL)
UD+: L19.3, Q44.4 (D+), Q48.6 (I/O4)
UD-: L19.2, Q44.5 (D-), Q48.4 (I/O3)
USB485_RXD: R296.1, U3.7 (P35)
USB485_TXD: R299.1, U3.11 (P34)
USB_D+: L19.4, Q46.A6 (D+), Q46.B6 (D+)
USB_D+5V: D37.2 (A), Q46.A4B9 (VBUS), Q46.B4A9 (VBUS)
USB_D-: L19.1, Q46.A7 (D-), Q46.B7 (D-)
VDD: C121.1, C122.1, C124.1, C134.1, C135.1, C142.1, C143.2, C144.1, C145.2, J1.1, J2.1, J5.1, J5.2, J6.1, J6.2, Q40.14 (VCC), Q42.5 (VREF), Q43.5 (VREF), Q45.2 (VO), Q47.8 (VCC), R287.1, R288.1, R289.2, R290.2, R297.1, R300.2, R303.2, R304.2, R307.2, R308.2, X1.4 (Vdd), X2.4 (Vdd)
XCLKOUT: U6.30 (P73)
~SPI_A_STE_HS: J7.3, U1.25 (P57)

Notes on the sheet:
电流采样用的20MHz时钟
ENPWM默认封波
H485接Unitree A1关节模组
Closed to connector
I2C接位移传感器
According to the order Layout
FSI*2菊花链接其他388芯片
HALL+EQEP=增量式编码器
CAN串行通讯
ETHERCAT
数字输入
PC-USB转串口
绝对值编码器CLB实现多摩川协议tformat）（本质上是用SPI外外设实现的！
PWM 使能 报错 ，ADC电流 电压 温度 ,刹车发波
信号灯
POWER 电源进！
28388
SPI接MAX5725DAC
