Acous1/mmlab-12PhaseDrive-388Slave/(commit log)

2025-04-16 1. 在USB处，修改了type-c5V输入的定义，添加了二极管；2. 将CJA1117B-3.3替换为AMS1117-3.3；3. 分配了testpoint的封装；4. 修改了H485，can插件的PE_GNG引脚定义。
    [26c32.kicad_sch, 5.kicad_sch, ETHERCAT.kicad_sch, ETHERCAT2.kicad_sch, H485.kicad_sch, IPM.kicad_sch, sheet1.kicad_sch]
2025-04-16 Fix bugs in PWM subsheet
    [26c32.kicad_sch, 5.kicad_sch, ETHERCAT.kicad_sch, ETHERCAT2.kicad_sch, H485.kicad_sch, IPM.kicad_sch, sheet1.kicad_sch]
